GigaOhms/KLTN/images/machDK.png

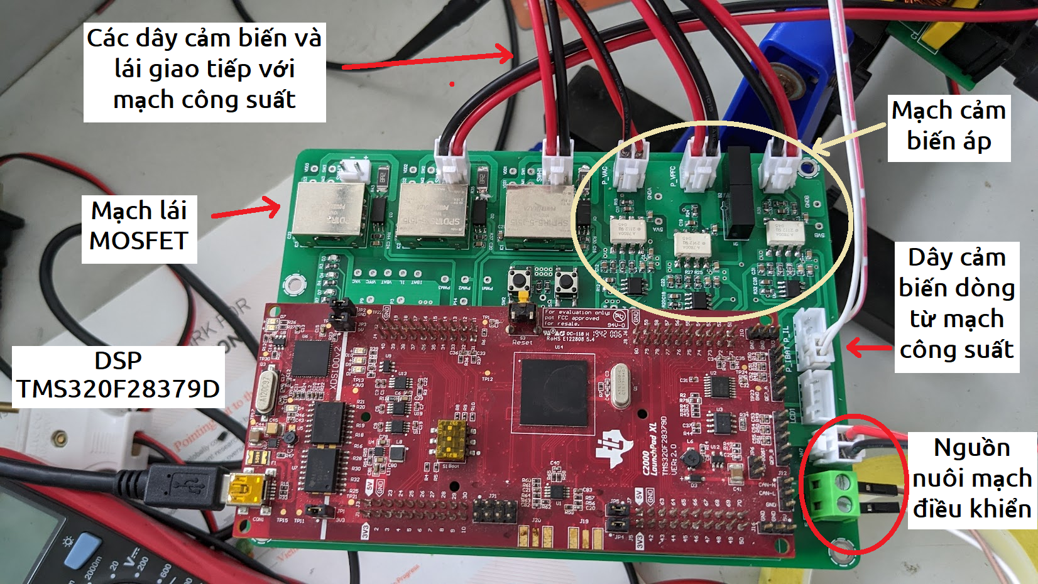
images/machDK.png
