GigaOhms/KLTN/images/ThucNghiem.png

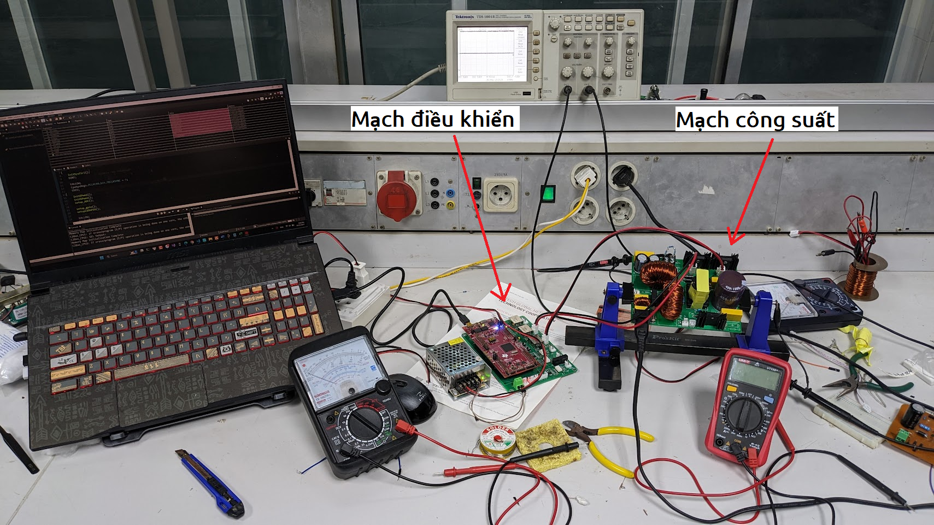
images/ThucNghiem.png
