GigaOhms/KLTN/images/2SWF_Wave.pdf

00
vL
(
m

a

g

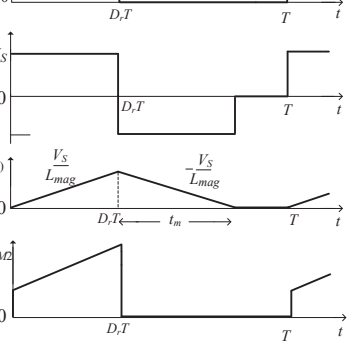
[picture p13: figure]
TDr

## )VS VS

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
VS2VS2

ttttttt

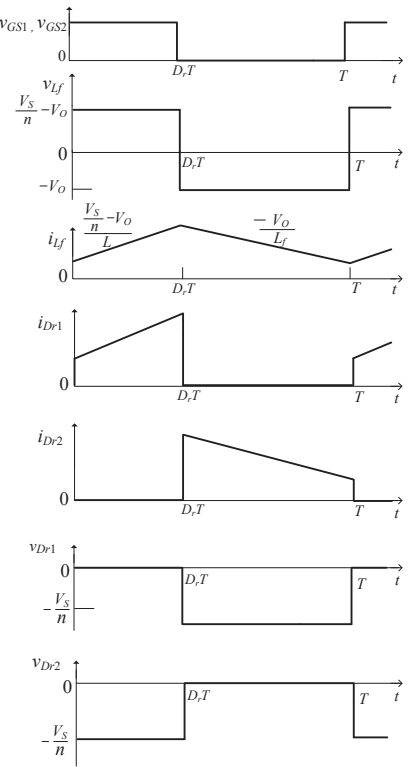
[picture p14: figure]
nVS; VOLf; VS nVS n; ttttttt; vLf iLf; TDr T

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
