GigaOhms/KLTN/Report/Calib.xlsx

 | VAC |  |  |  |  |  | VPFC |  |  |  |  |  | VBAT
 | Cal | Meas | Real (peak - DC) |  | Cal/Meas |  | Cal | Meas | Real |  | Cal/Meas |  | Cal | Meas | Real |  | Cal/Meas
1.122926244 | 1.147511493 | 1.239 | 25 | 1.179 | 139.6648045 | 157.2327044 | 2.524590164 | 2.38 | 310 | 2.32 | 238.4615385 |  | 2.538932517 | 2.4 | 30 | 2.34 | 22.3880597 | 22.72727273 | 22.70727273
1.245852489 | 1.295022986 | 1.38 | 50 | 1.32 | 156.25 | 166.6666667 | 2.573770492 | 2.4 | 320 | 2.34 | 242.4242424 |  | 2.590230268 | 2.44 | 31 | 2.38 | 22.46376812 | 22.79411765 | 22.77411765
1.491704977 | 1.590045972 | 1.64 | 100 | 1.58 | 172.4137931 | 178.5714286 | 2.62295082 | 2.43 | 330 | 2.37 | 244.4444444 |  | 2.641528018 | 2.47 | 32 | 2.41 | 22.69503546 | 23.02158273 | 23.00158273
1.614631221 | 1.737557466 | 1.77 | 125 | 1.71 | 176.056338 | 181.1594203 | 2.672131148 | 2.45 | 340 | 2.39 | 248.1751825 |  | 2.692825769 | 2.5 | 33 | 2.44 | 22.91666667 | 23.23943662 | 23.21943662
1.737557466 | 1.885068959 | 1.87 | 150 | 1.81 | 185.1851852 | 189.8734177 | 2.721311475 | 2.49 | 350 | 2.43 | 248.2269504 |  | 2.744123519 | 2.52 | 34 | 2.46 | 23.28767123 | 23.61111111 | 23.59111111
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
