GigaOhms/KLTN/images/cathode.jpg

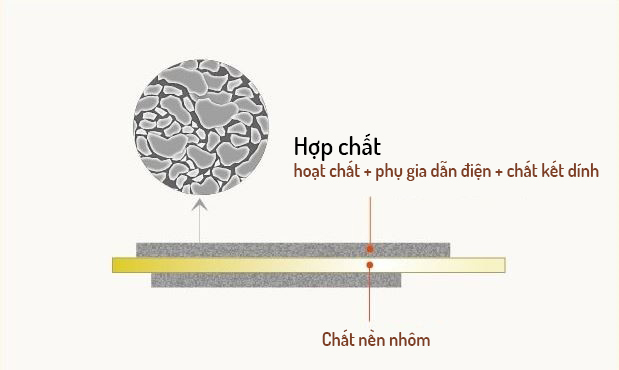
images/cathode.jpg
