GigaOhms/KLTN/images/cc-cv.jpg

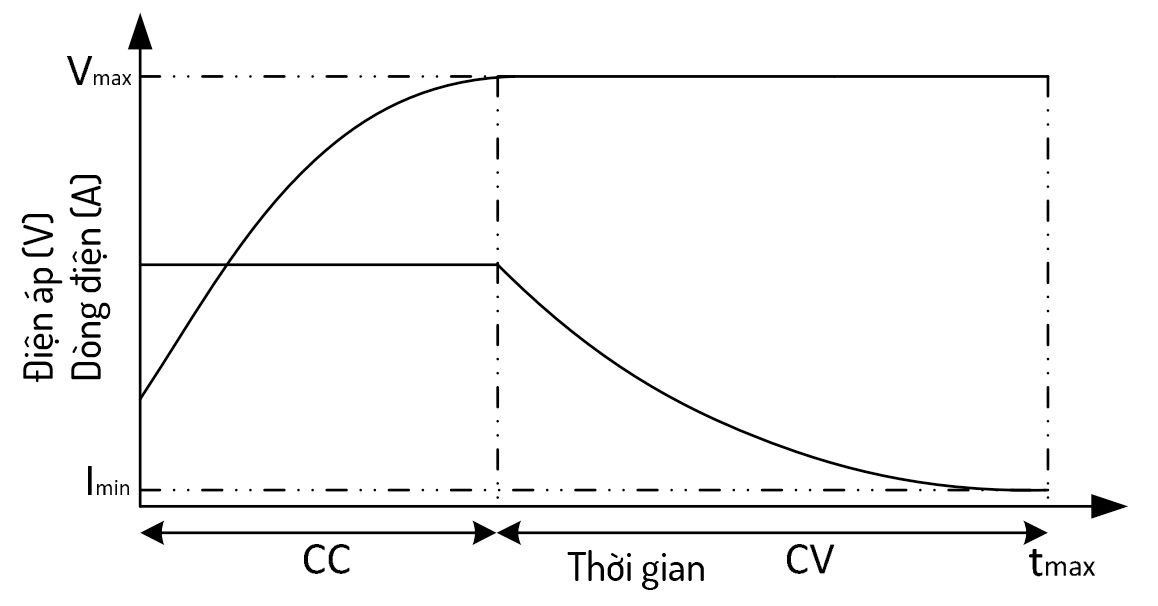
images/cc-cv.jpg
