GigaOhms/KLTN/images/CC_CV.drawio.png

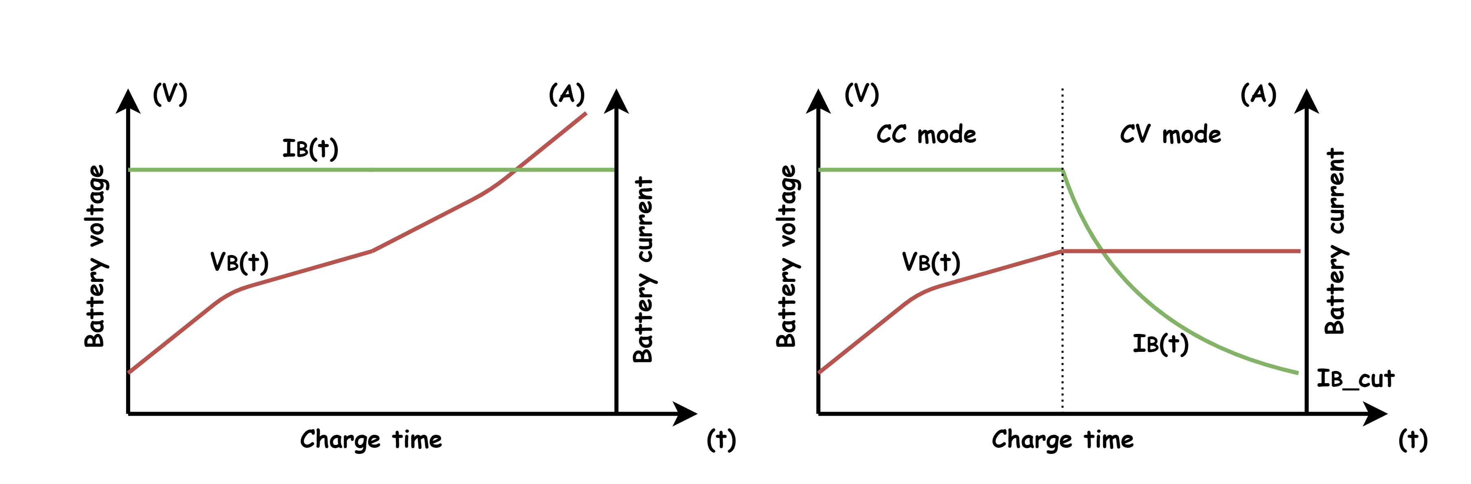
images/CC_CV.drawio.png
