GigaOhms/KLTN/images/CCM.png

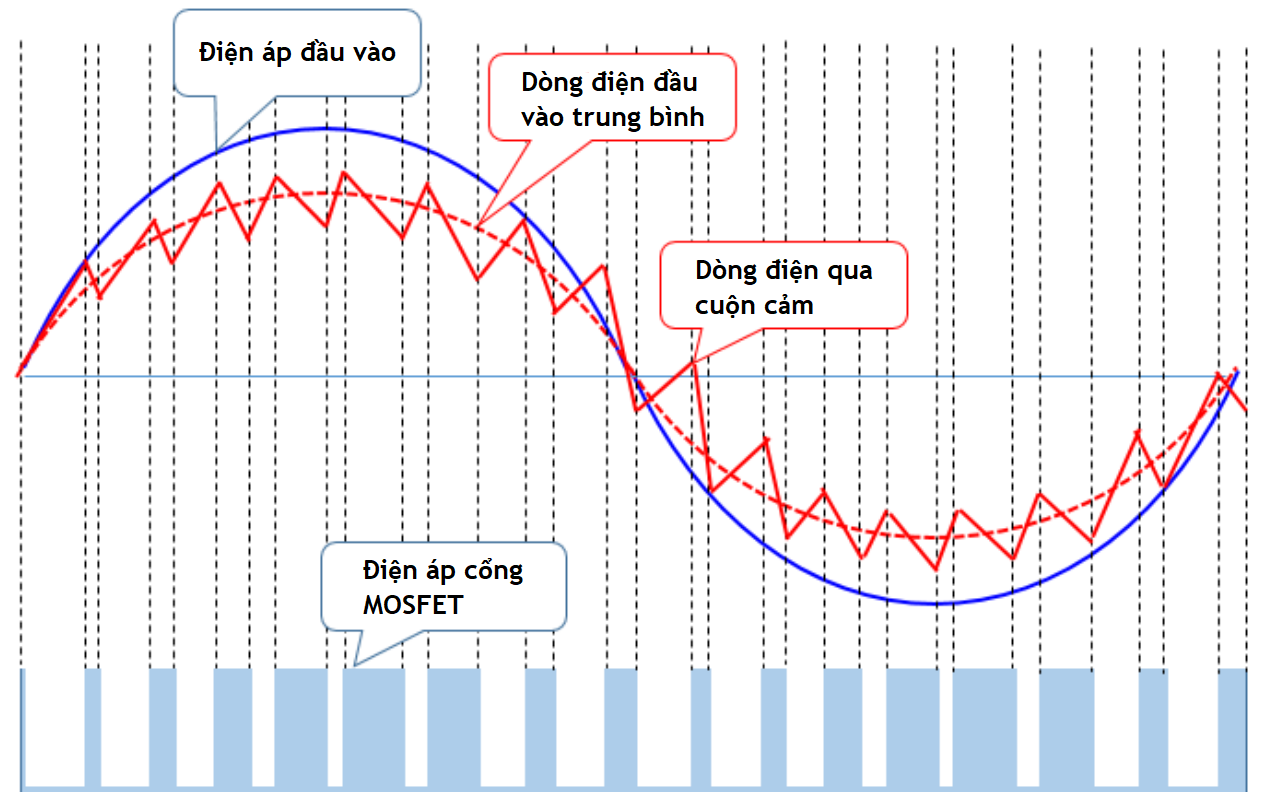
images/CCM.png
