GigaOhms/KLTN/images/charge.jpg

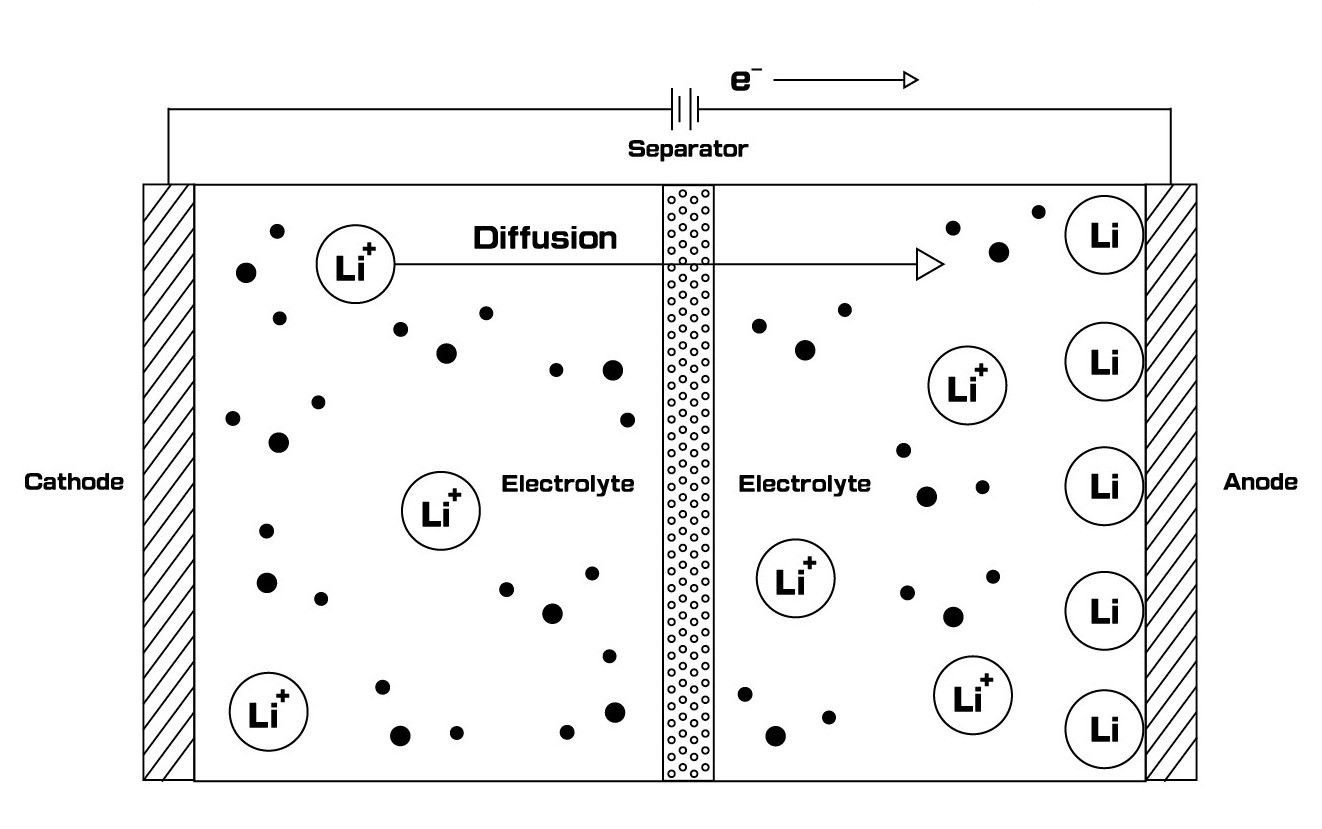
images/charge.jpg
