GigaOhms/KLTN/images/CRM.png

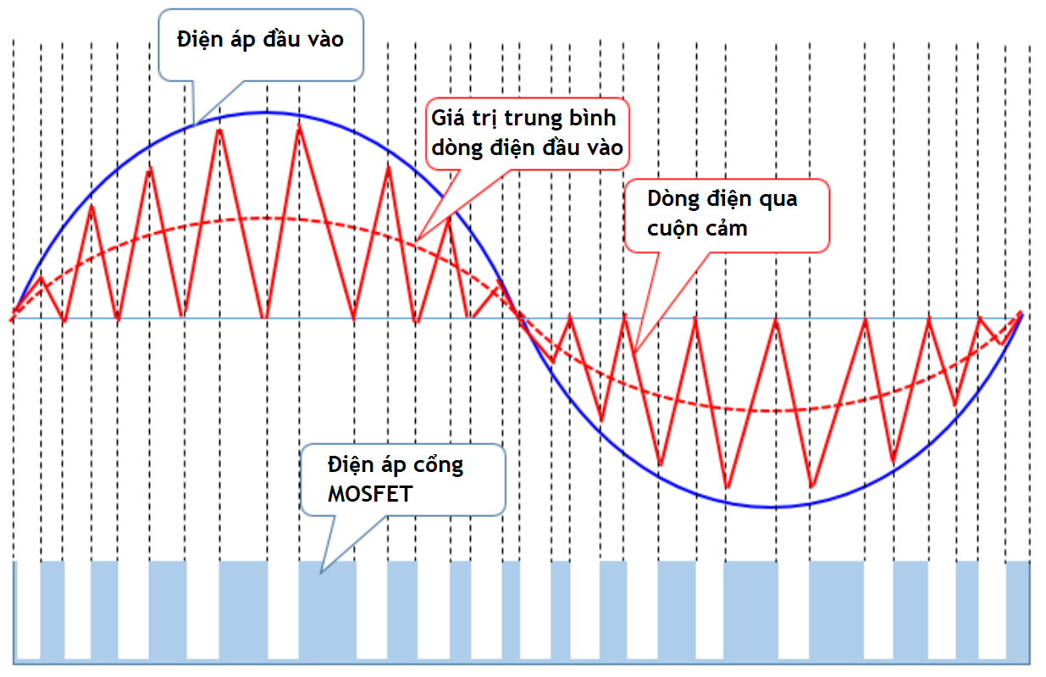
images/CRM.png
