GigaOhms/KLTN/images/CurrentIncresaEachCycle.png

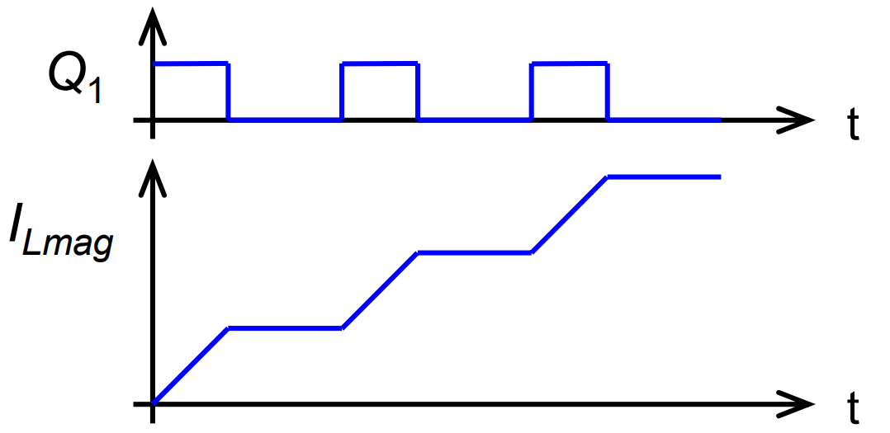
images/CurrentIncresaEachCycle.png
