GigaOhms/KLTN/images/DCM.png

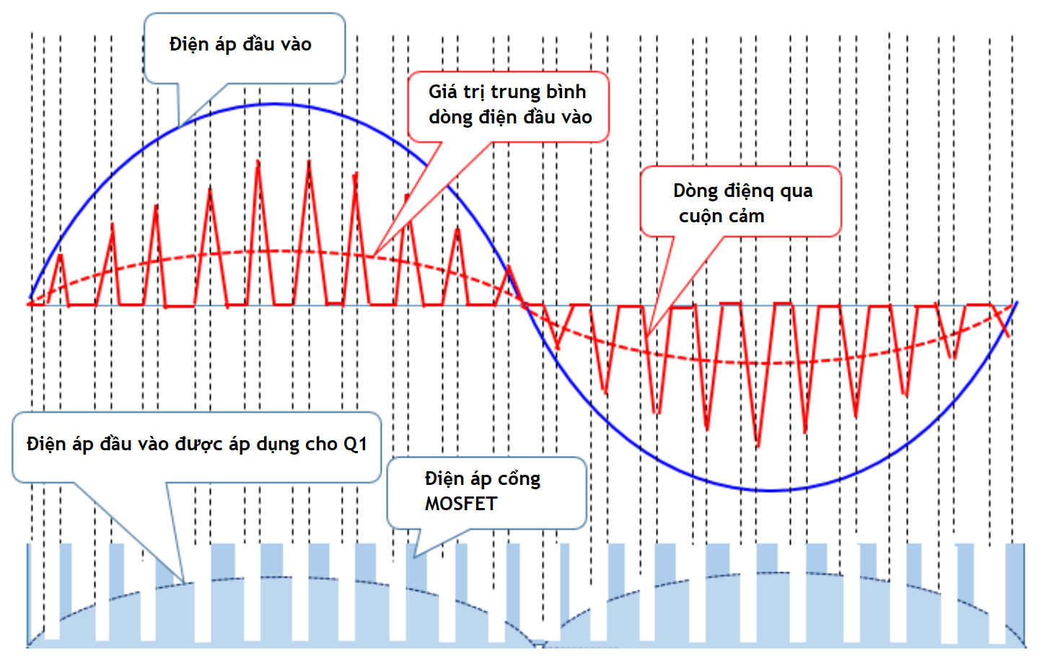
images/DCM.png
