GigaOhms/KLTN/images/discharge.jpg

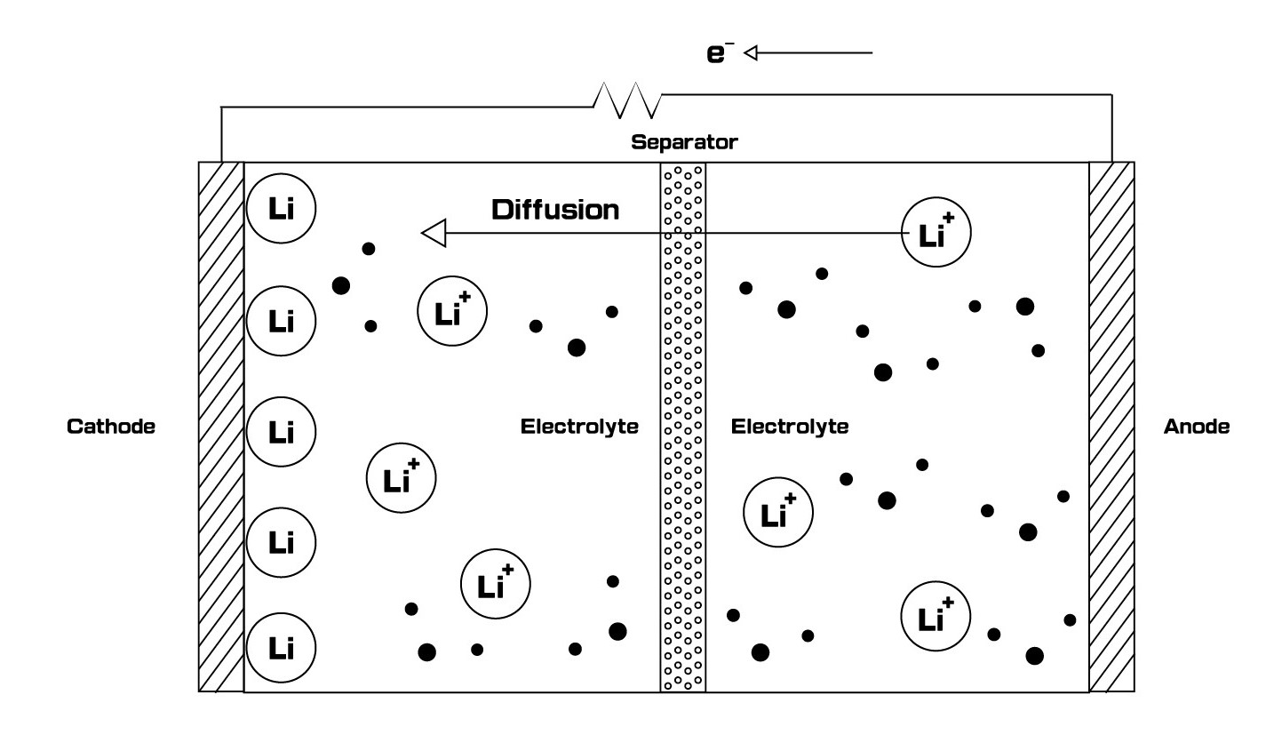
images/discharge.jpg
