GigaOhms/KLTN/images/electrist.jpg

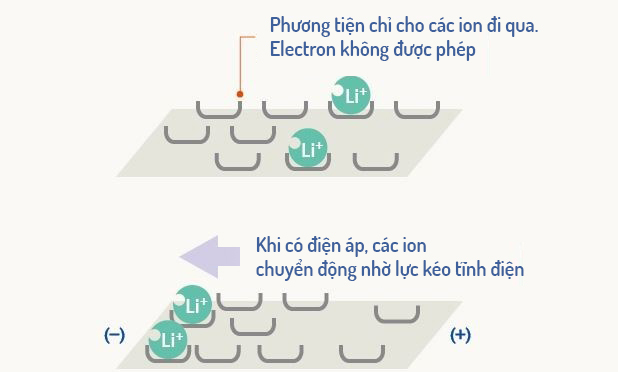
images/electrist.jpg
