GigaOhms/KLTN/images/Five-stage CC charging.jpg

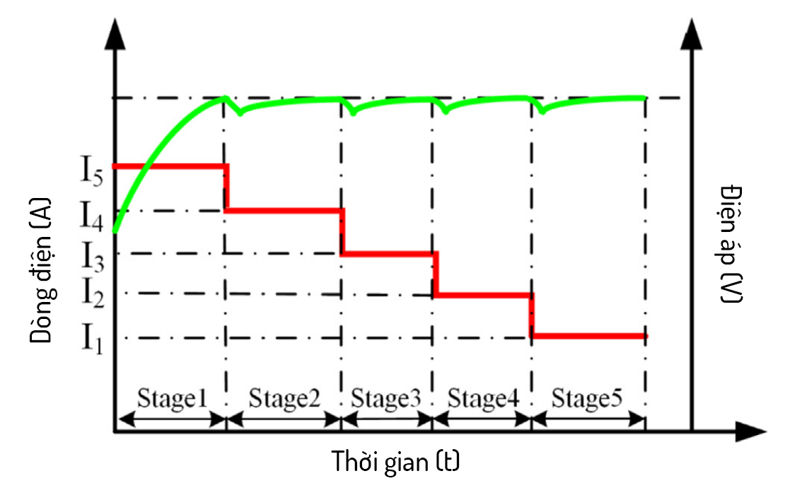
images/Five-stage CC charging.jpg
