GigaOhms/KLTN/images/fourElement.jpg

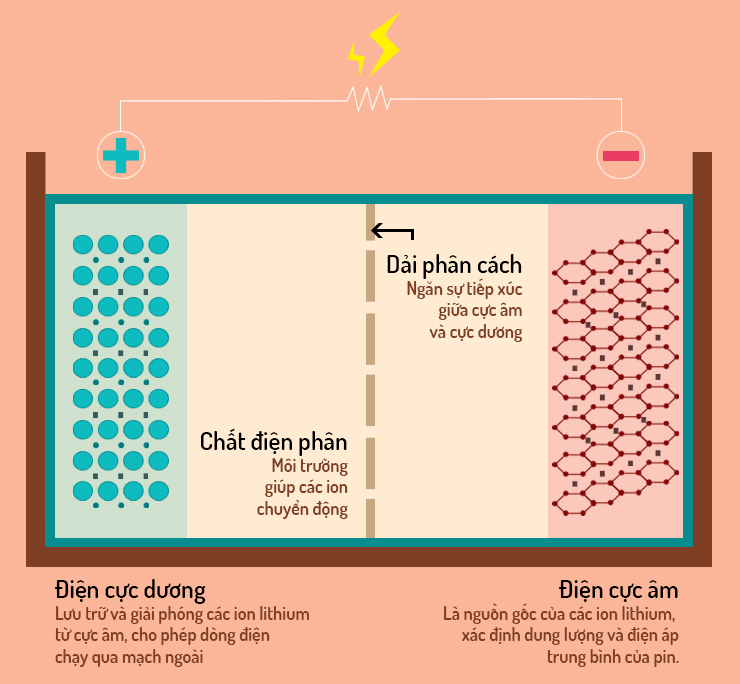
images/fourElement.jpg
