GigaOhms/KLTN/images/HD_NCKH.png

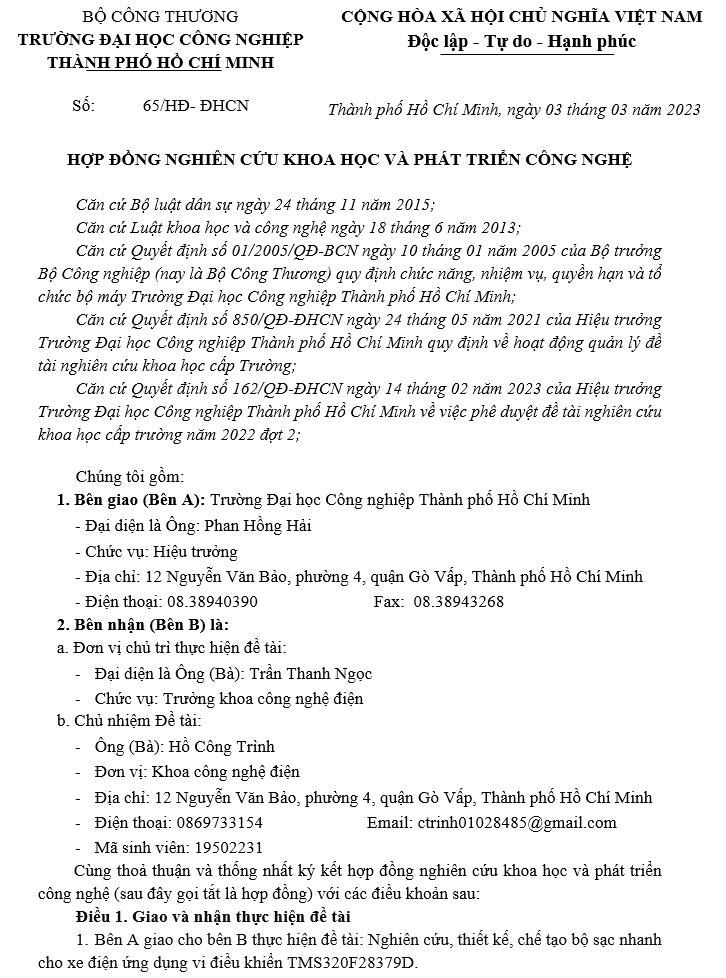
images/HD_NCKH.png
