GigaOhms/KLTN/images/iBATVBAT.png

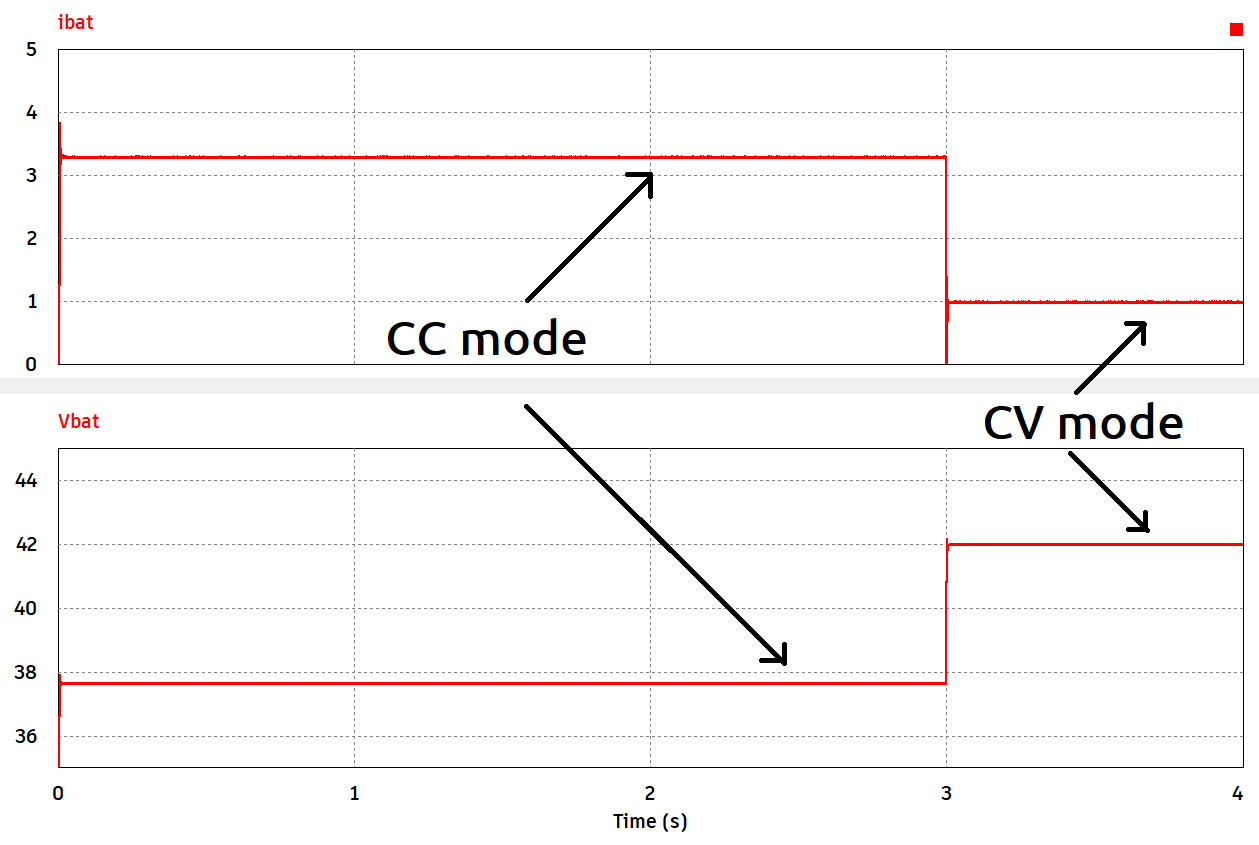
images/iBATVBAT.png
