GigaOhms/KLTN/images/iDviGBT_2sfw.png

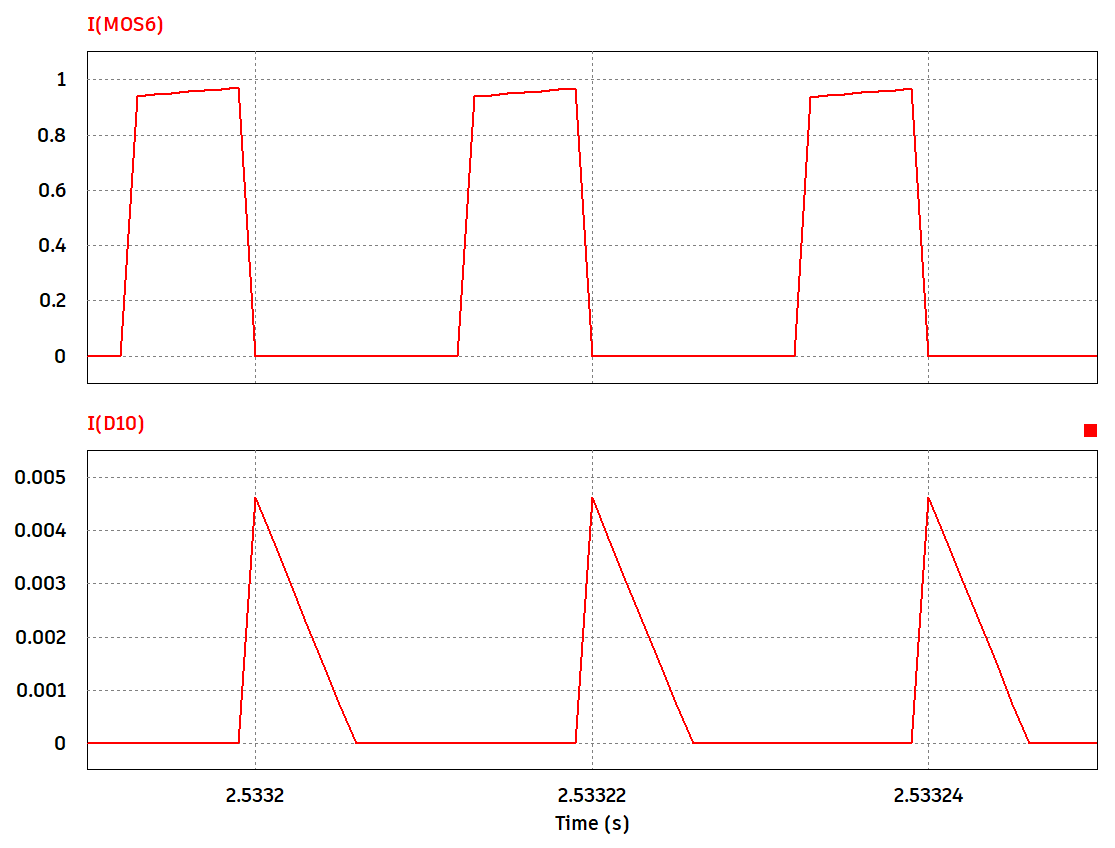
images/iDviGBT_2sfw.png
