GigaOhms/KLTN/images/iGBTviD.png

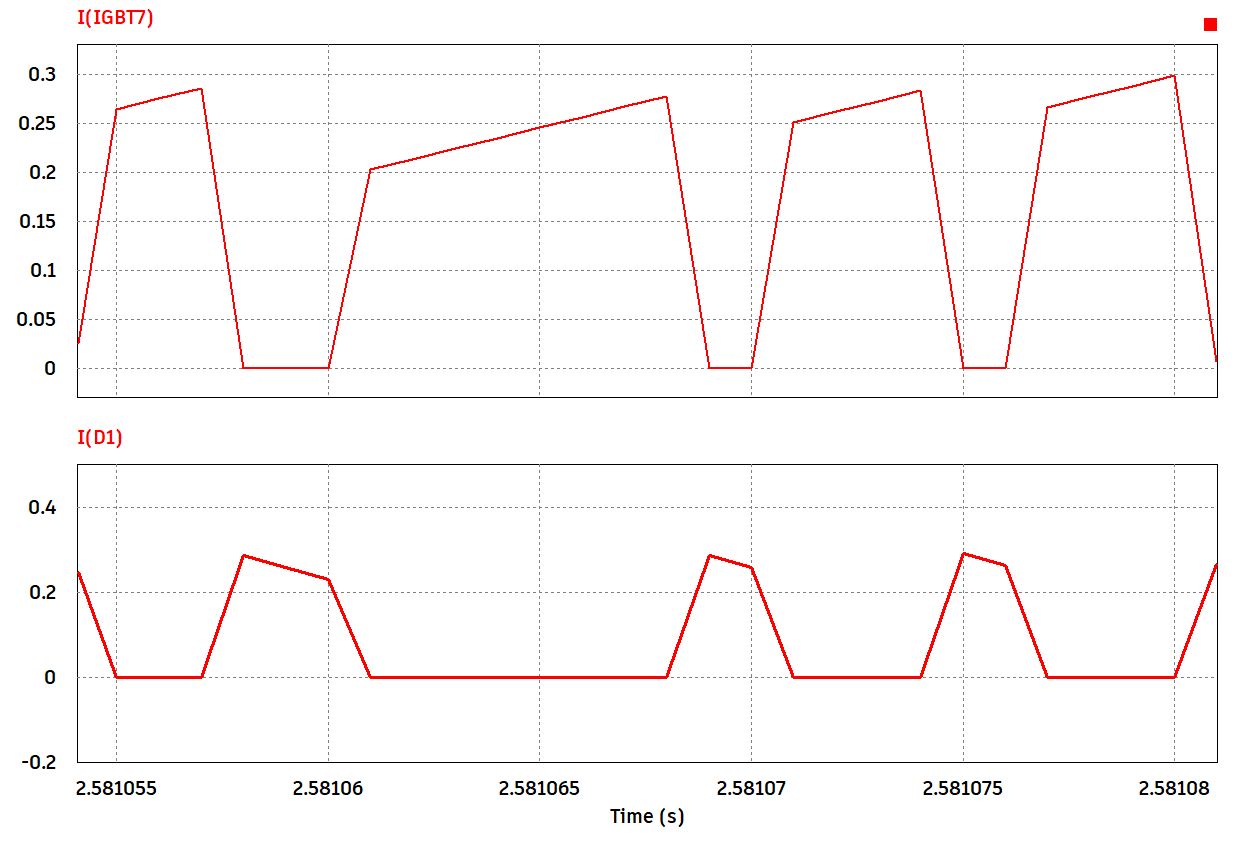
images/iGBTviD.png
