GigaOhms/KLTN/images/iLviGBT.png

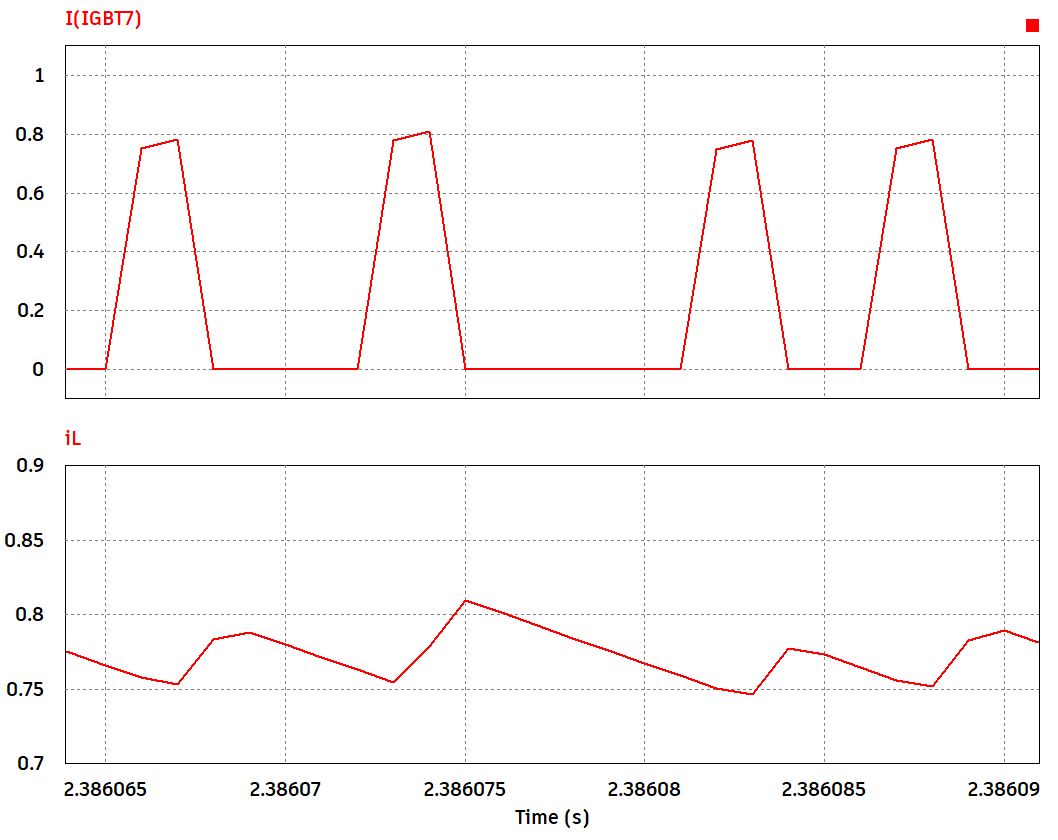
images/iLviGBT.png
