GigaOhms/KLTN/images/Improved CC-CV methods.jpg

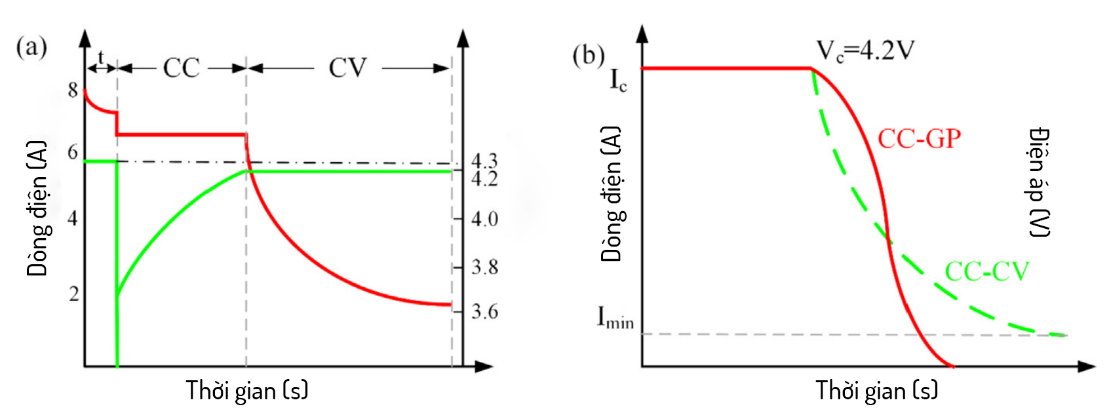
images/Improved CC-CV methods.jpg
