GigaOhms/KLTN/images/machCongSuat.png

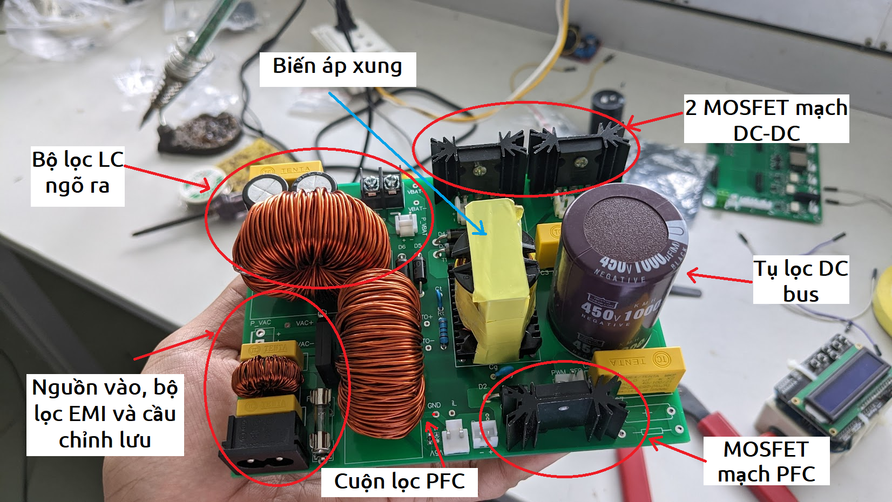
images/machCongSuat.png
