GigaOhms/KLTN/images/MoHinh.png

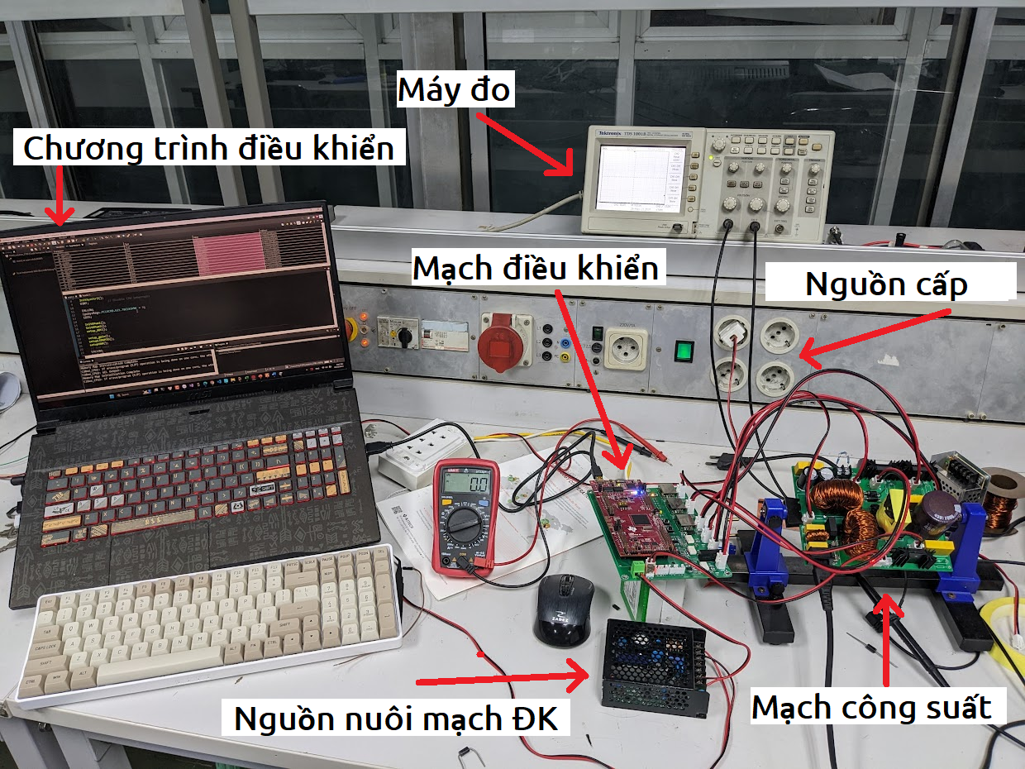
images/MoHinh.png
