GigaOhms/KLTN/images/NoneLinearLoad.png

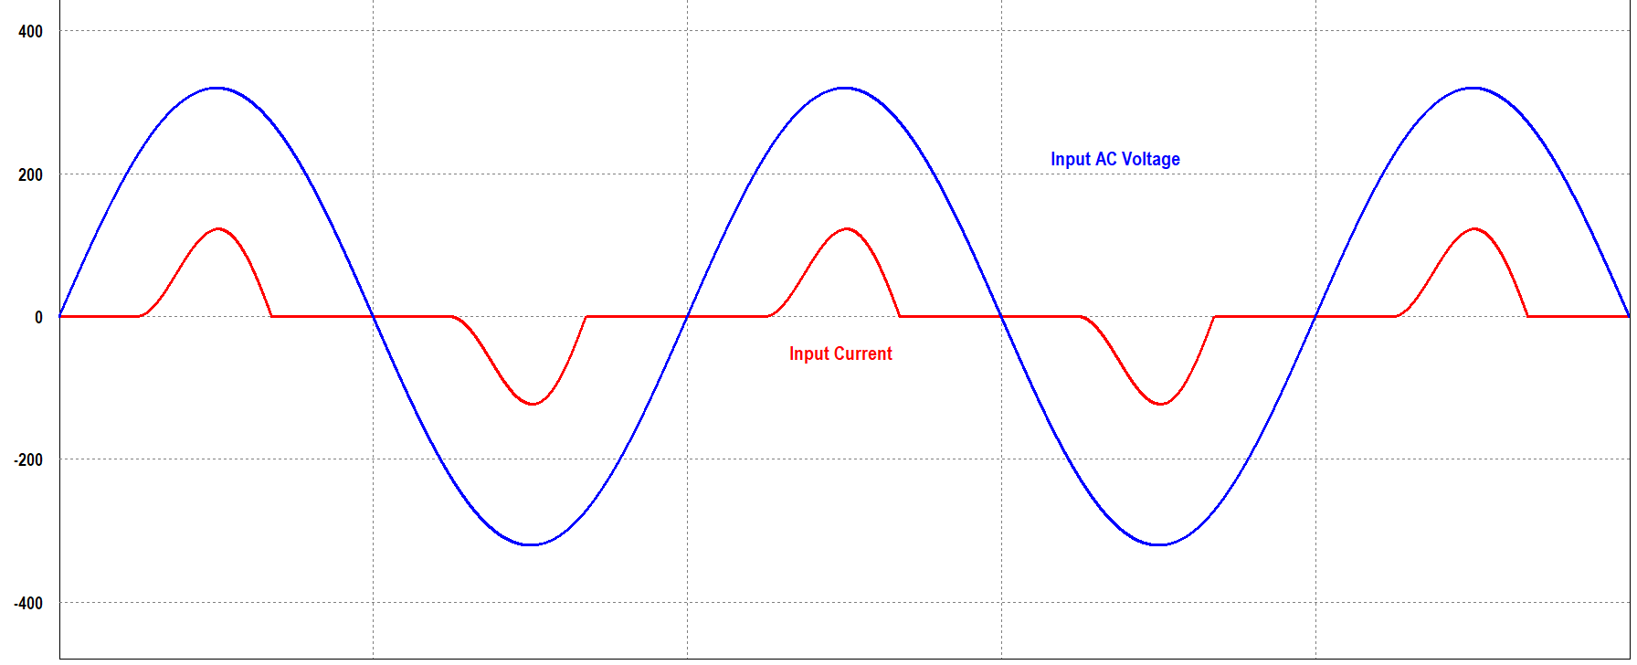
images/NoneLinearLoad.png
