GigaOhms/KLTN/images/NonLinearLoad.png

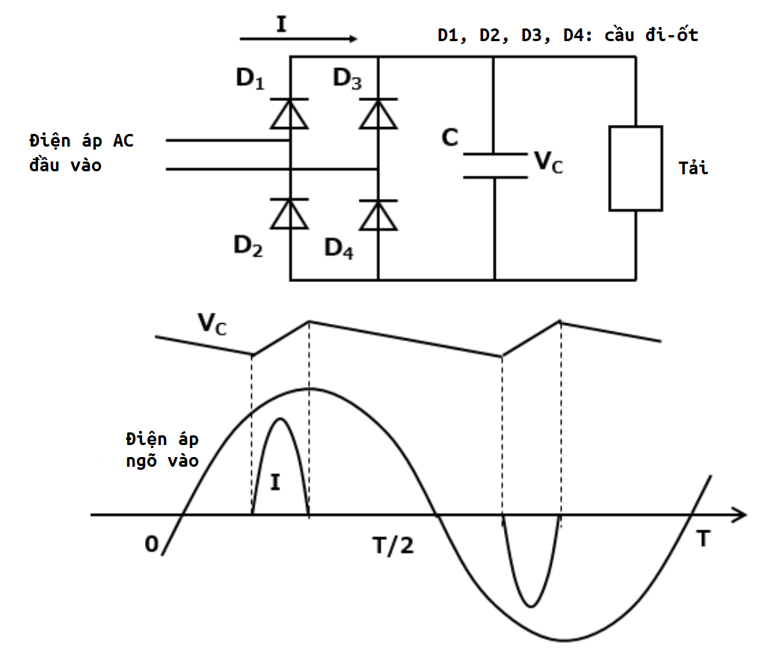
images/NonLinearLoad.png
