GigaOhms/KLTN/images/pfc1-01.png

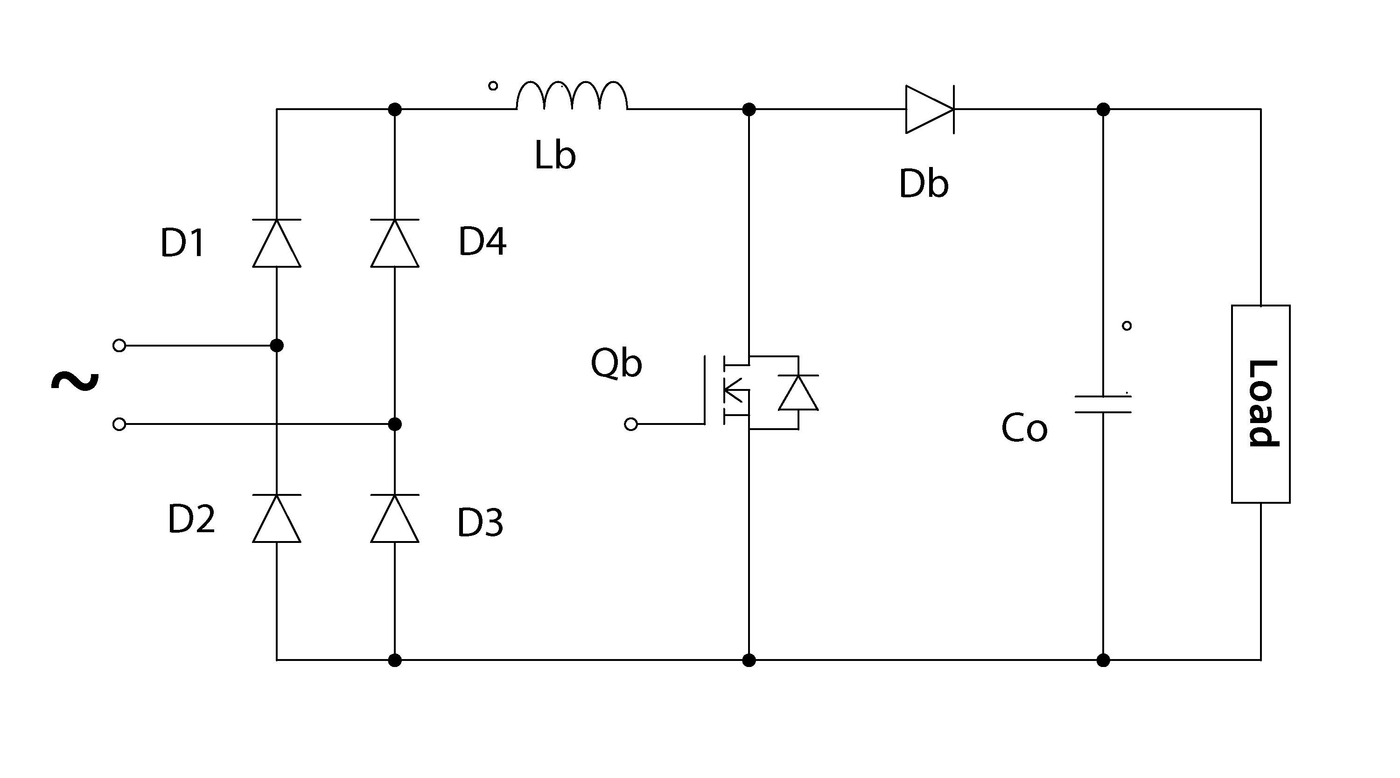
images/pfc1-01.png
