GigaOhms/KLTN/images/pfc2-01.png

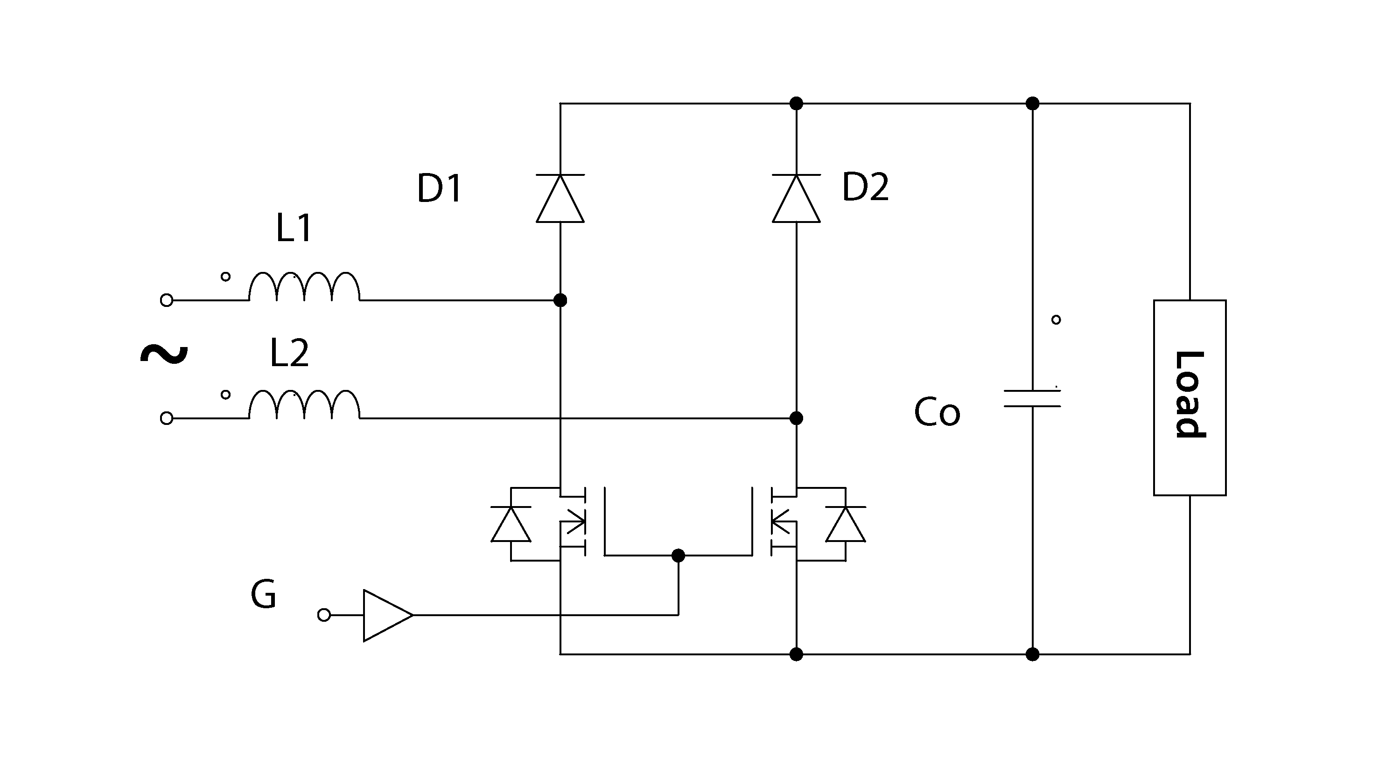
images/pfc2-01.png
