GigaOhms/KLTN/images/pfc3-01.png

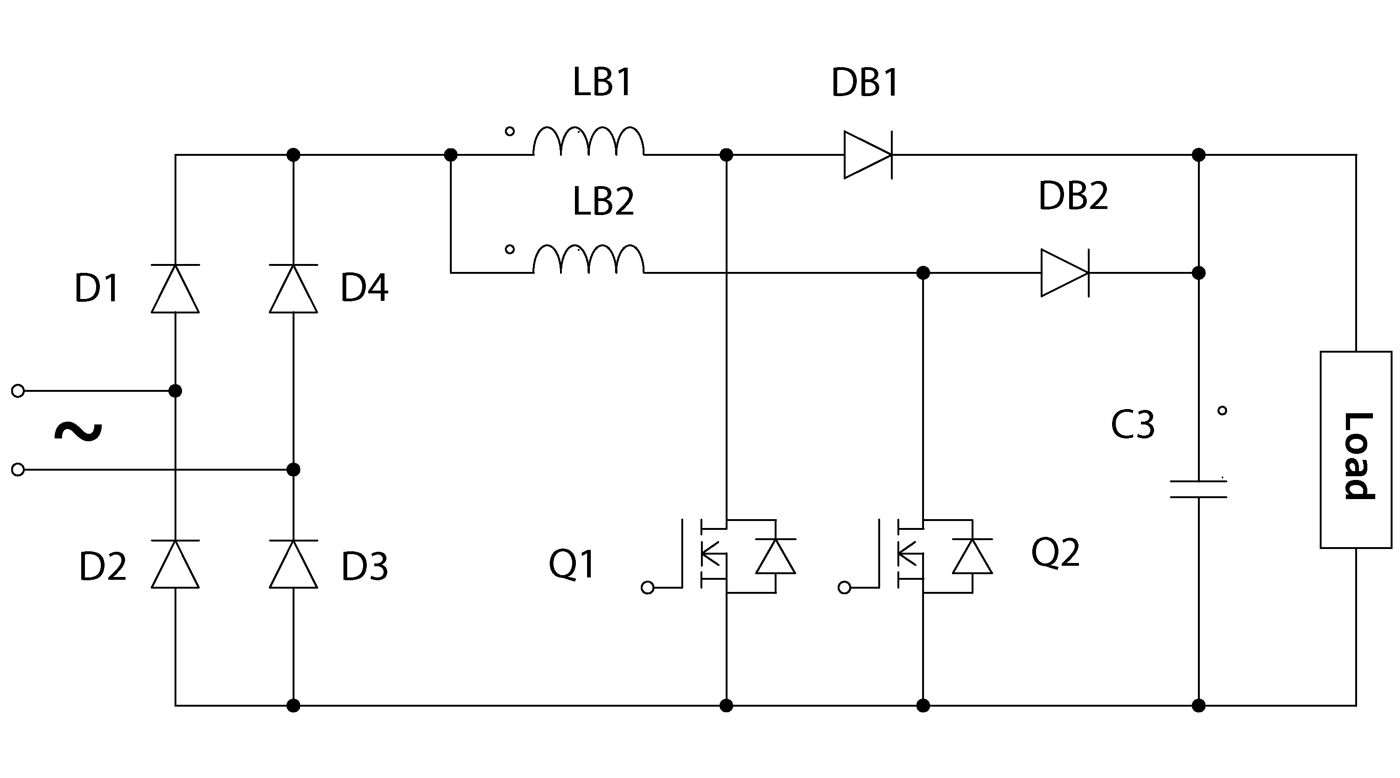
images/pfc3-01.png
