GigaOhms/KLTN/images/pfc4 - topo-01-01.png

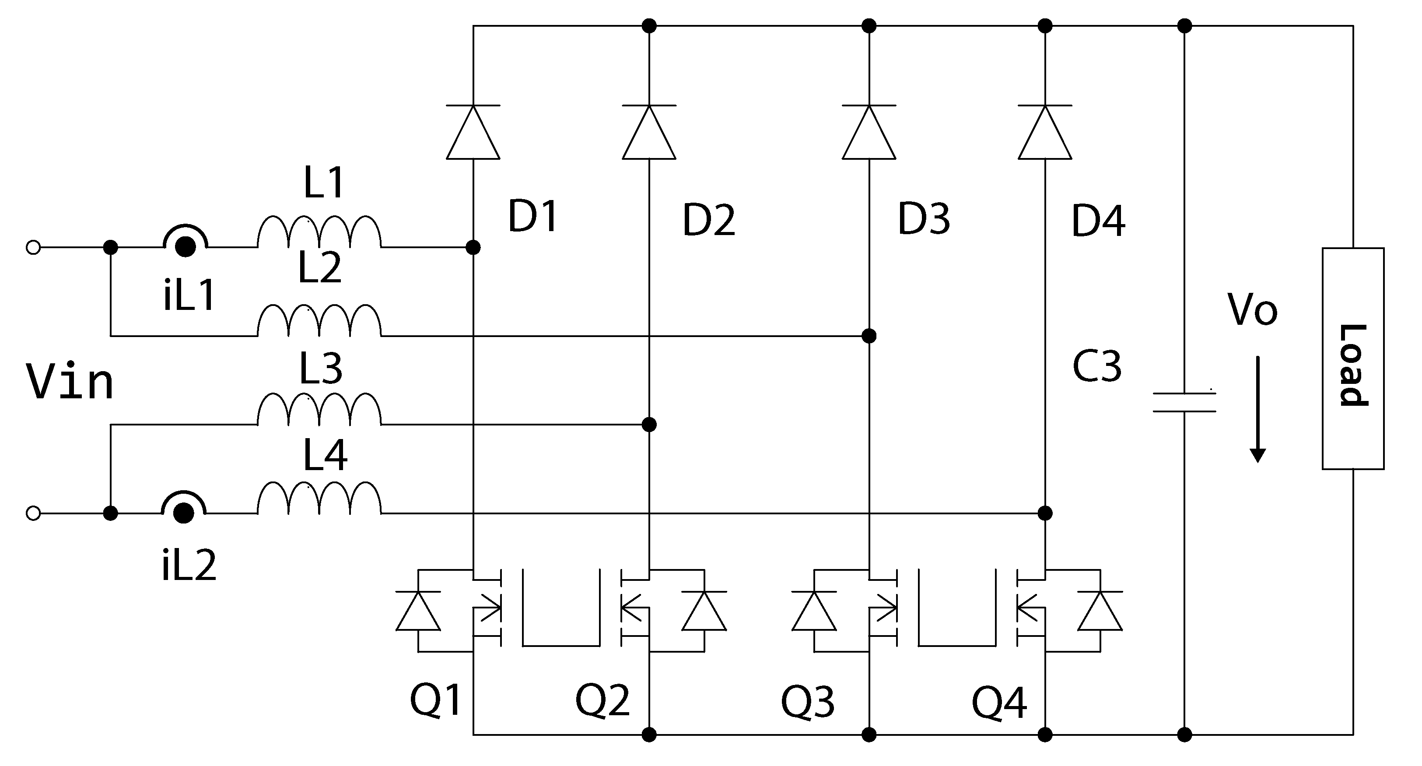
images/pfc4 - topo-01-01.png
