GigaOhms/KLTN/images/PFC-01.png

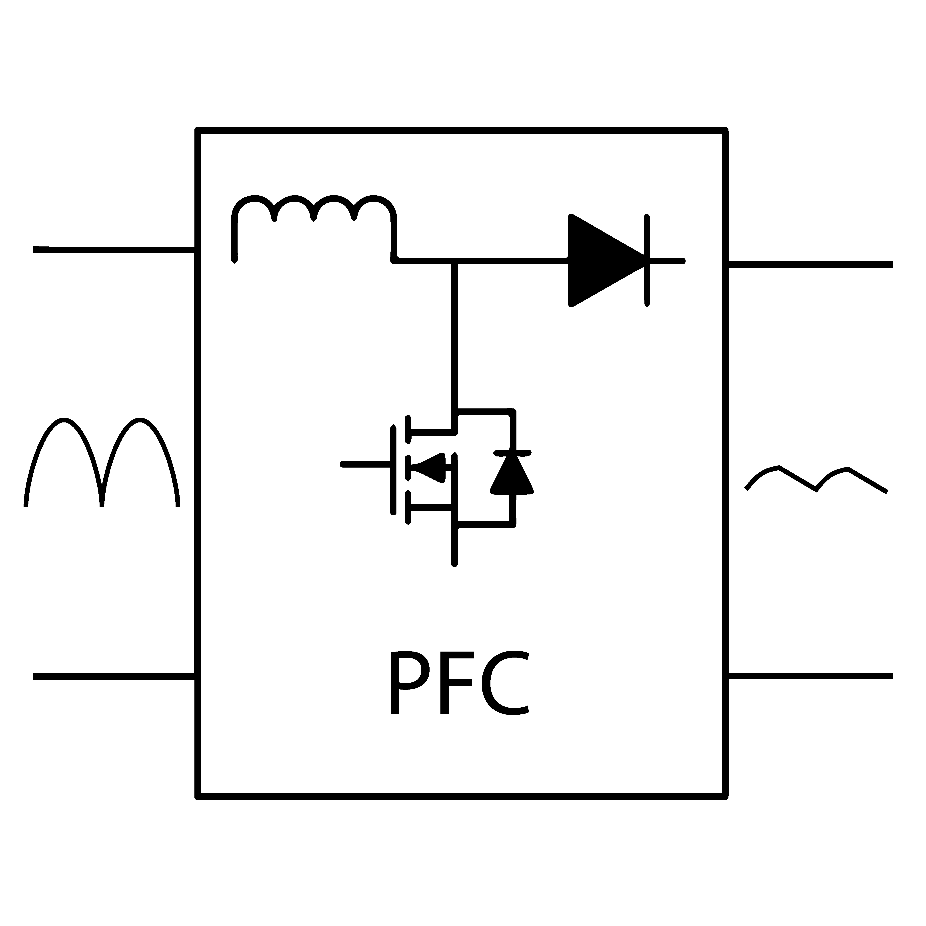
images/PFC-01.png
