GigaOhms/KLTN/images/PFvTHD.png

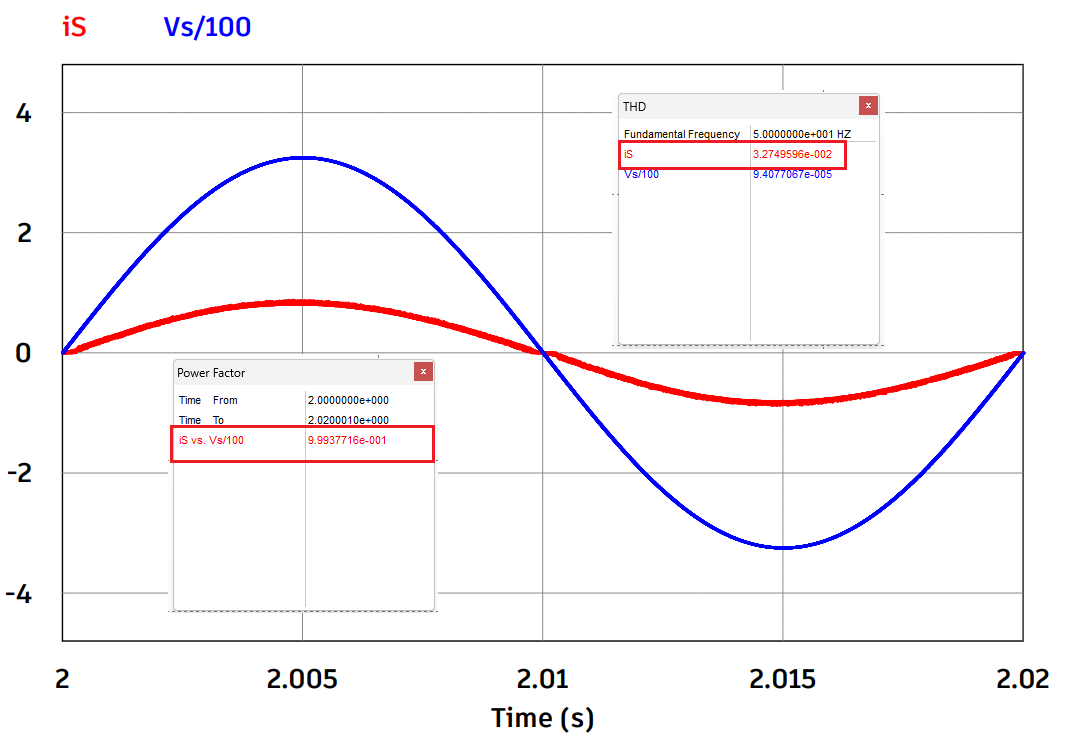
images/PFvTHD.png
