GigaOhms/KLTN/images/separator.png

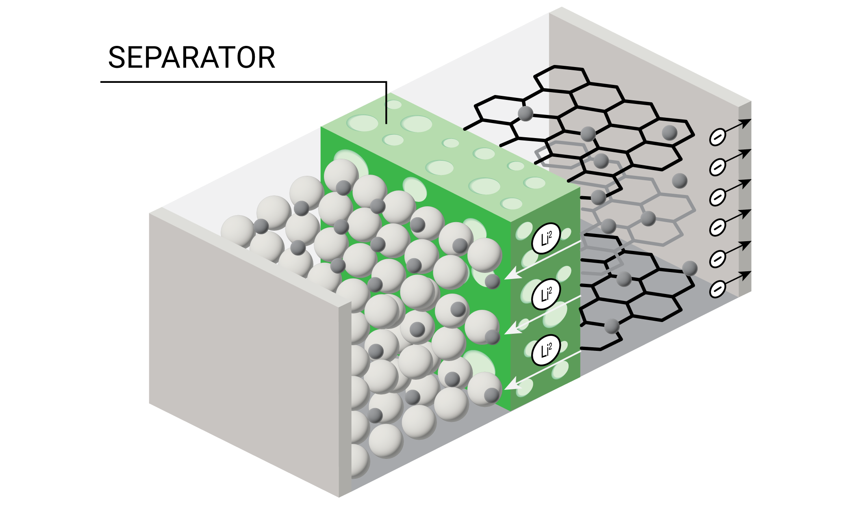
images/separator.png
