GigaOhms/KLTN/images/TM_Tram.png

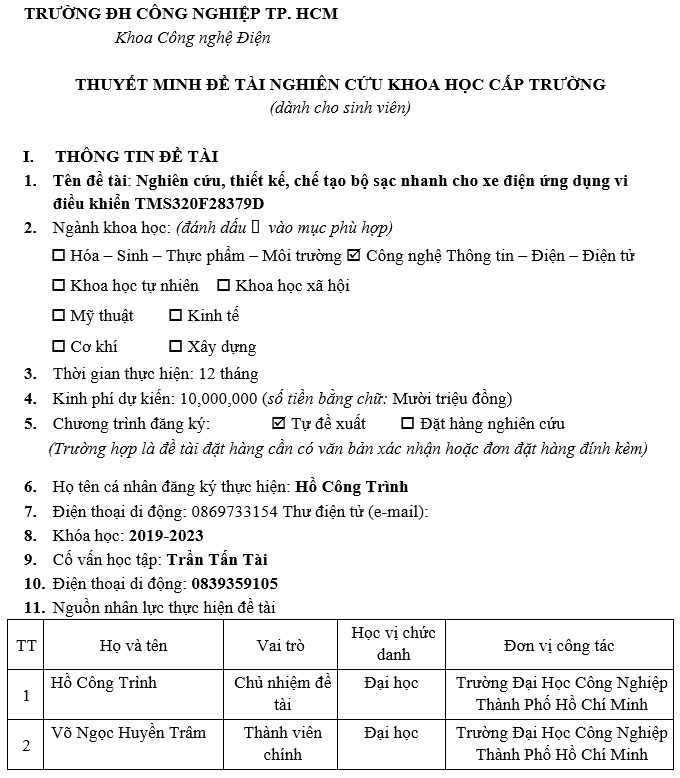
images/TM_Tram.png
