GigaOhms/KLTN/images/universalBatteryCharger.drawio.png

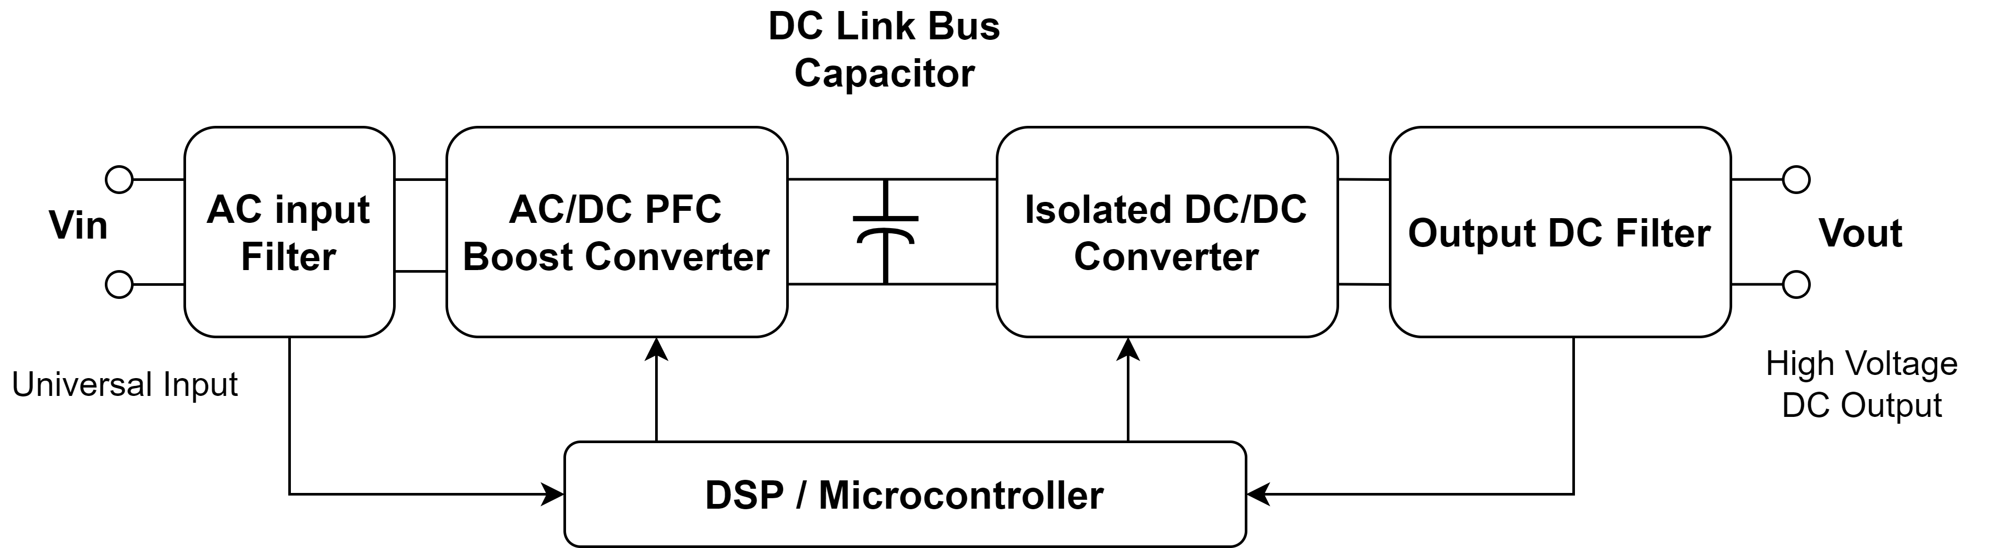
images/universalBatteryCharger.drawio.png
