GigaOhms/KLTN/images/Vbus.png

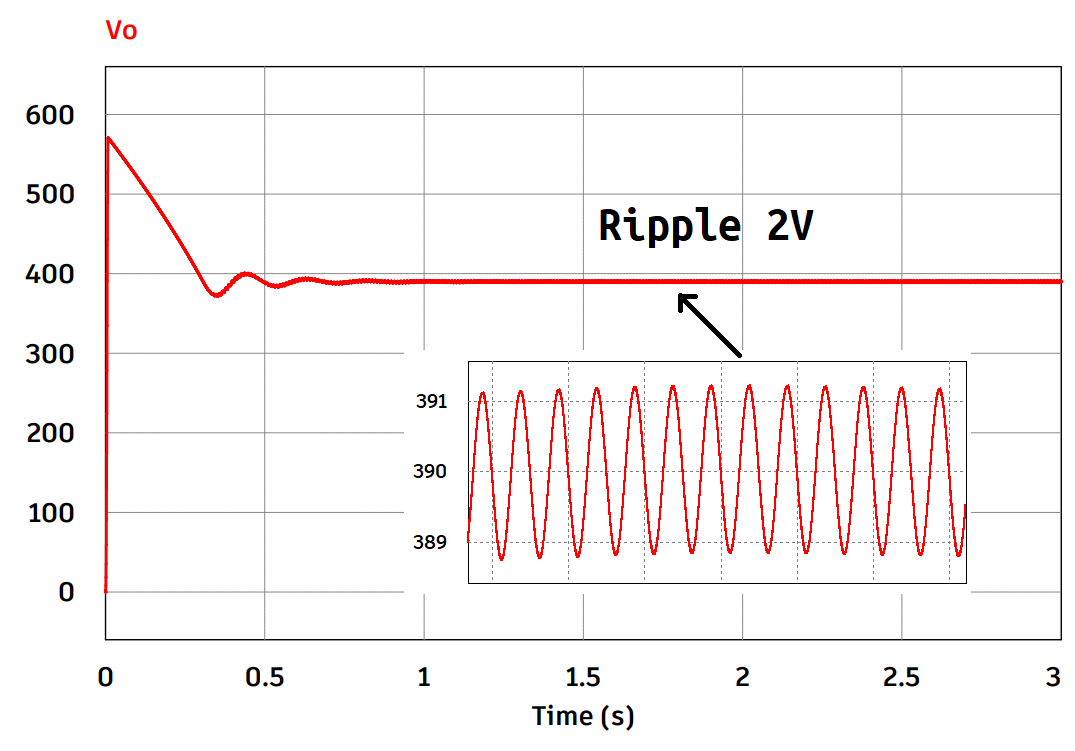
images/Vbus.png
