GigaOhms/KLTN/images/YSC1.png

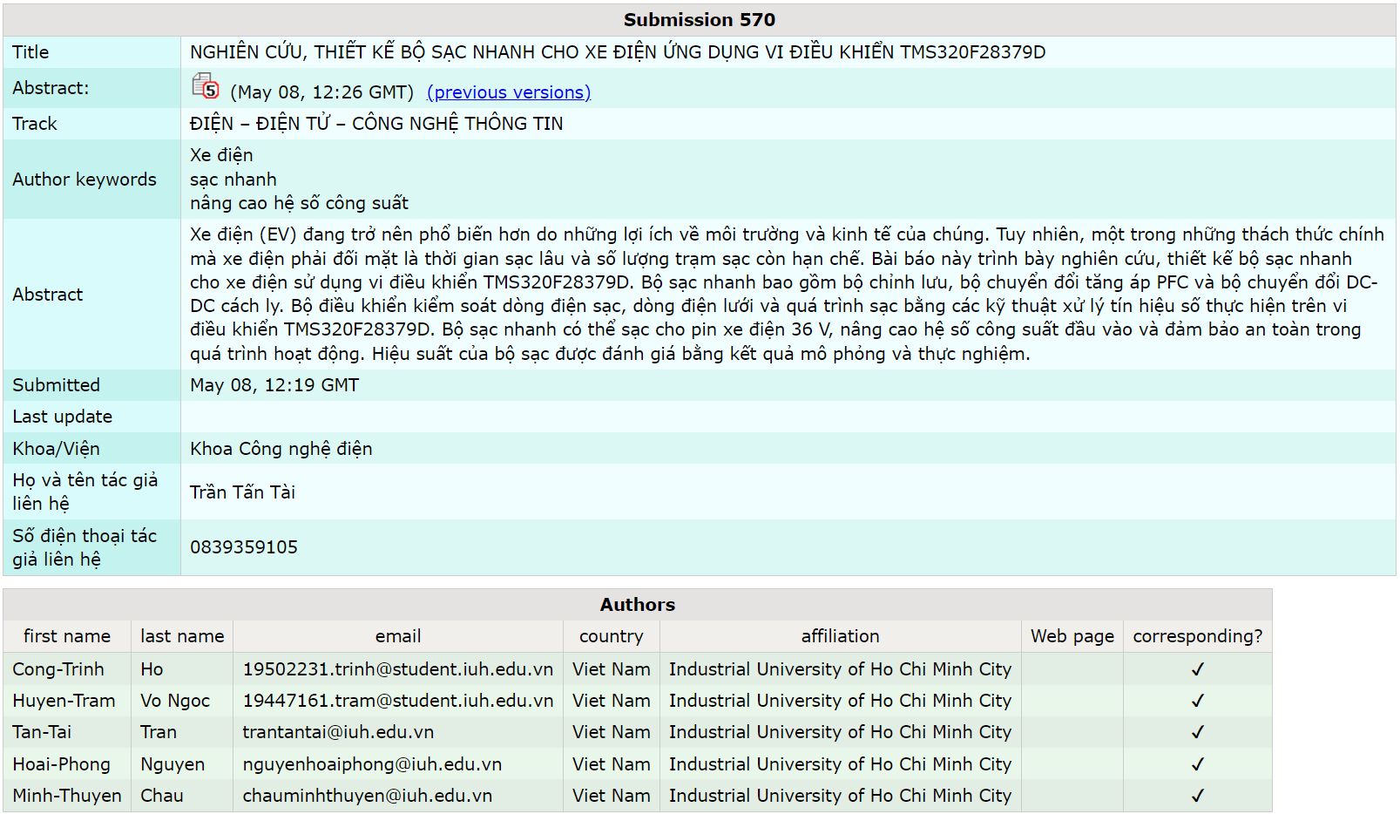
images/YSC1.png
