GigaOhms/KLTN/images/YSC2.png

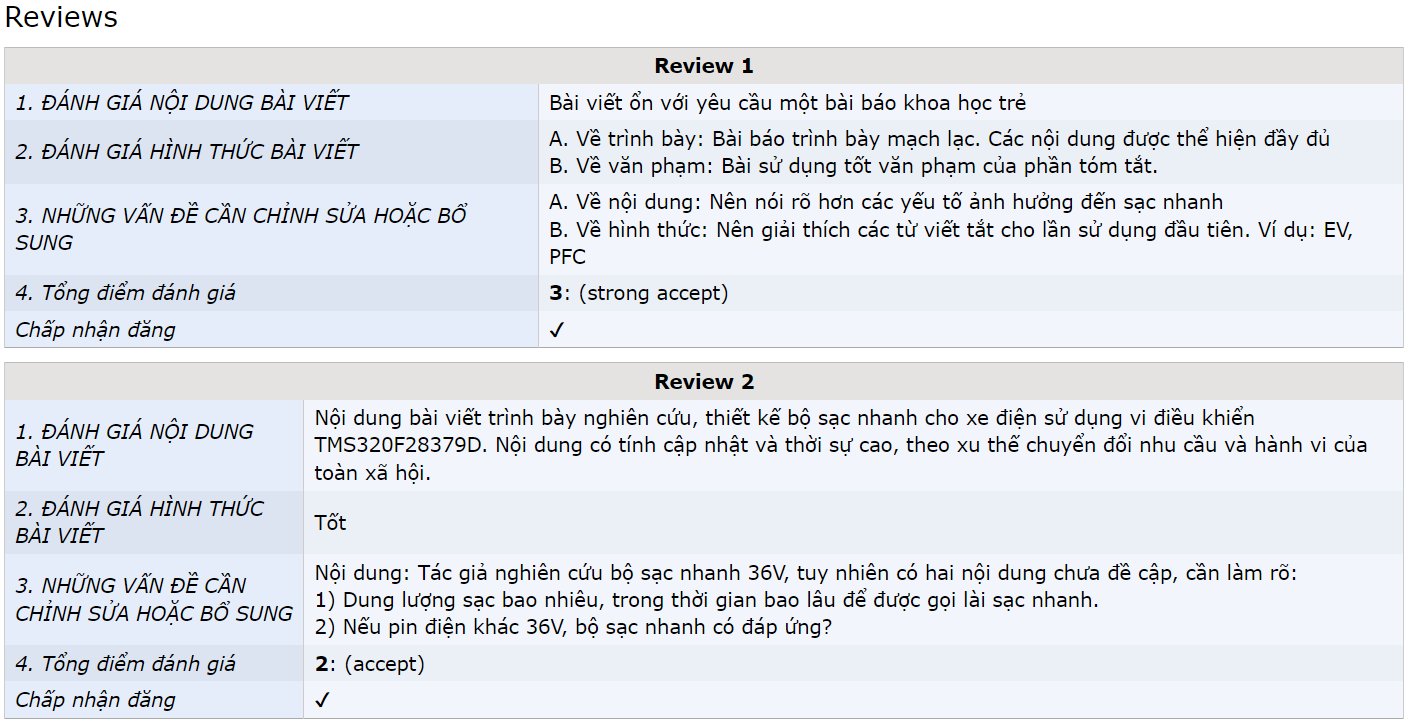
images/YSC2.png
