GigaOhms/KLTN/(list of files, cad)

Other CAD files:
Code/RANDOM/CPU1_RAM/main.obj
Code/RANDOM/CPU1_FLASH/main.obj
Code/RANDOM/CPU1_FLASH/F2837xD_CodeStartBranch.obj
Code/RANDOM/CPU1_RAM/F2837xD_EPwm.obj
Code/RANDOM/CPU1_FLASH/F2837xD_PieVect.obj
Code/RANDOM/CPU1_RAM/F2837xD_PieVect.obj
Code/RANDOM/CPU1_FLASH/F2837xD_Gpio.obj
Code/RANDOM/CPU1_RAM/F2837xD_Adc.obj
Code/RANDOM/CPU1_FLASH/F2837xD_EPwm.obj
Code/RANDOM/CPU1_RAM/F2837xD_usDelay.obj
Code/RANDOM/CPU1_FLASH/F2837xD_CpuTimers.obj
Code/RANDOM/CPU1_FLASH/F2837xD_SysCtrl.obj
Code/RANDOM/CPU1_RAM/F2837xD_DefaultISR.obj
Code/RANDOM/CPU1_FLASH/F2837xD_usDelay.obj
Code/RANDOM/CPU1_RAM/F2837xD_GlobalVariableDefs.obj
Code/RANDOM/CPU1_FLASH/F2837xD_PieCtrl.obj
Code/RANDOM/CPU1_RAM/F2837xD_CpuTimers.obj
Code/RANDOM/CPU1_FLASH/F2837xD_Adc.obj
Code/RANDOM/CPU1_RAM/epwm_updown_aq_cpu01.obj
Code/RANDOM/CPU1_FLASH/F2837xD_DefaultISR.obj
Code/RANDOM/CPU1_RAM/F2837xD_PieCtrl.obj
Code/RANDOM/CPU1_RAM/F2837xD_Gpio.obj
Code/RANDOM/CPU1_FLASH/F2837xD_Ipc.obj
Code/RANDOM/CPU1_RAM/F2837xD_Ipc.obj
Code/RANDOM/CPU1_FLASH/F2837xD_GlobalVariableDefs.obj
Code/RANDOM/CPU1_RAM/F2837xD_SysCtrl.obj
Code/RANDOM/CPU1_RAM/F2837xD_CodeStartBranch.obj
