GigaOhms/KLTN/images/ThreeStep2SWF.png

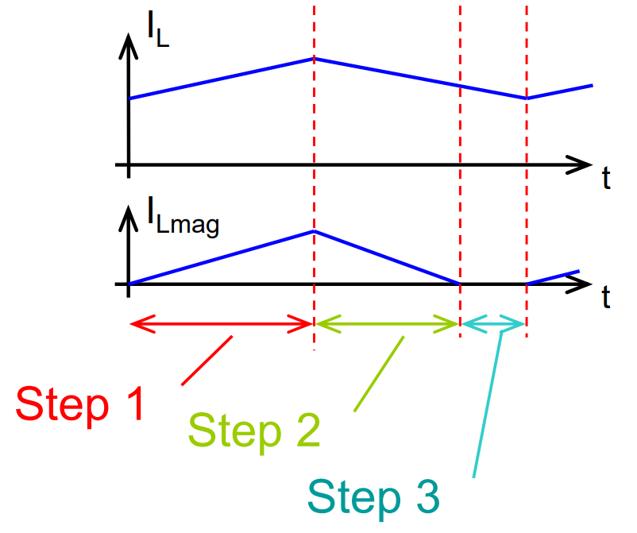
images/ThreeStep2SWF.png
