GigaOhms/KLTN/PCB/ControlBoard/ControlBoardSchematic.pdf

# GNDLED¹

# GNDLED³

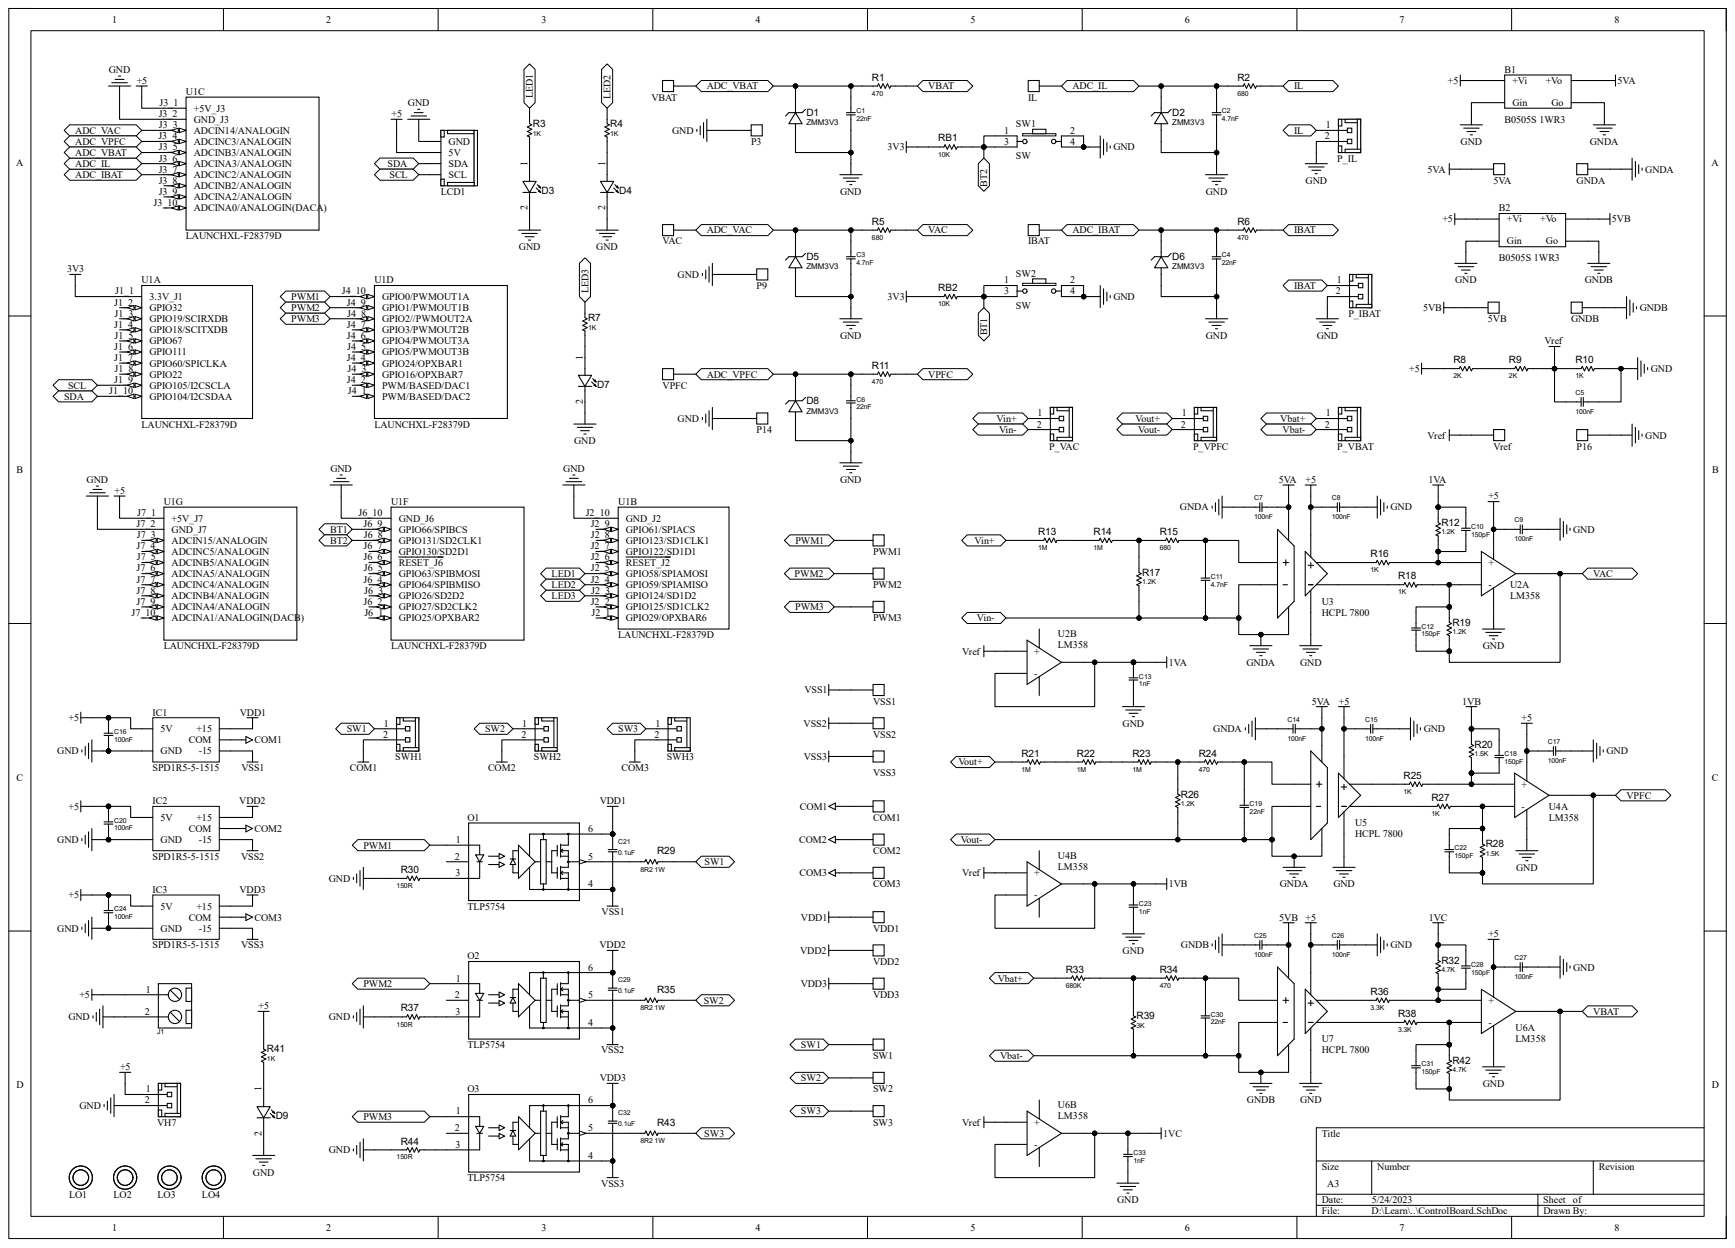
[picture p50: page 1]
