GigaOhms/KLTN/PCB/PowerBoard/PowerBoardSchematic.pdf

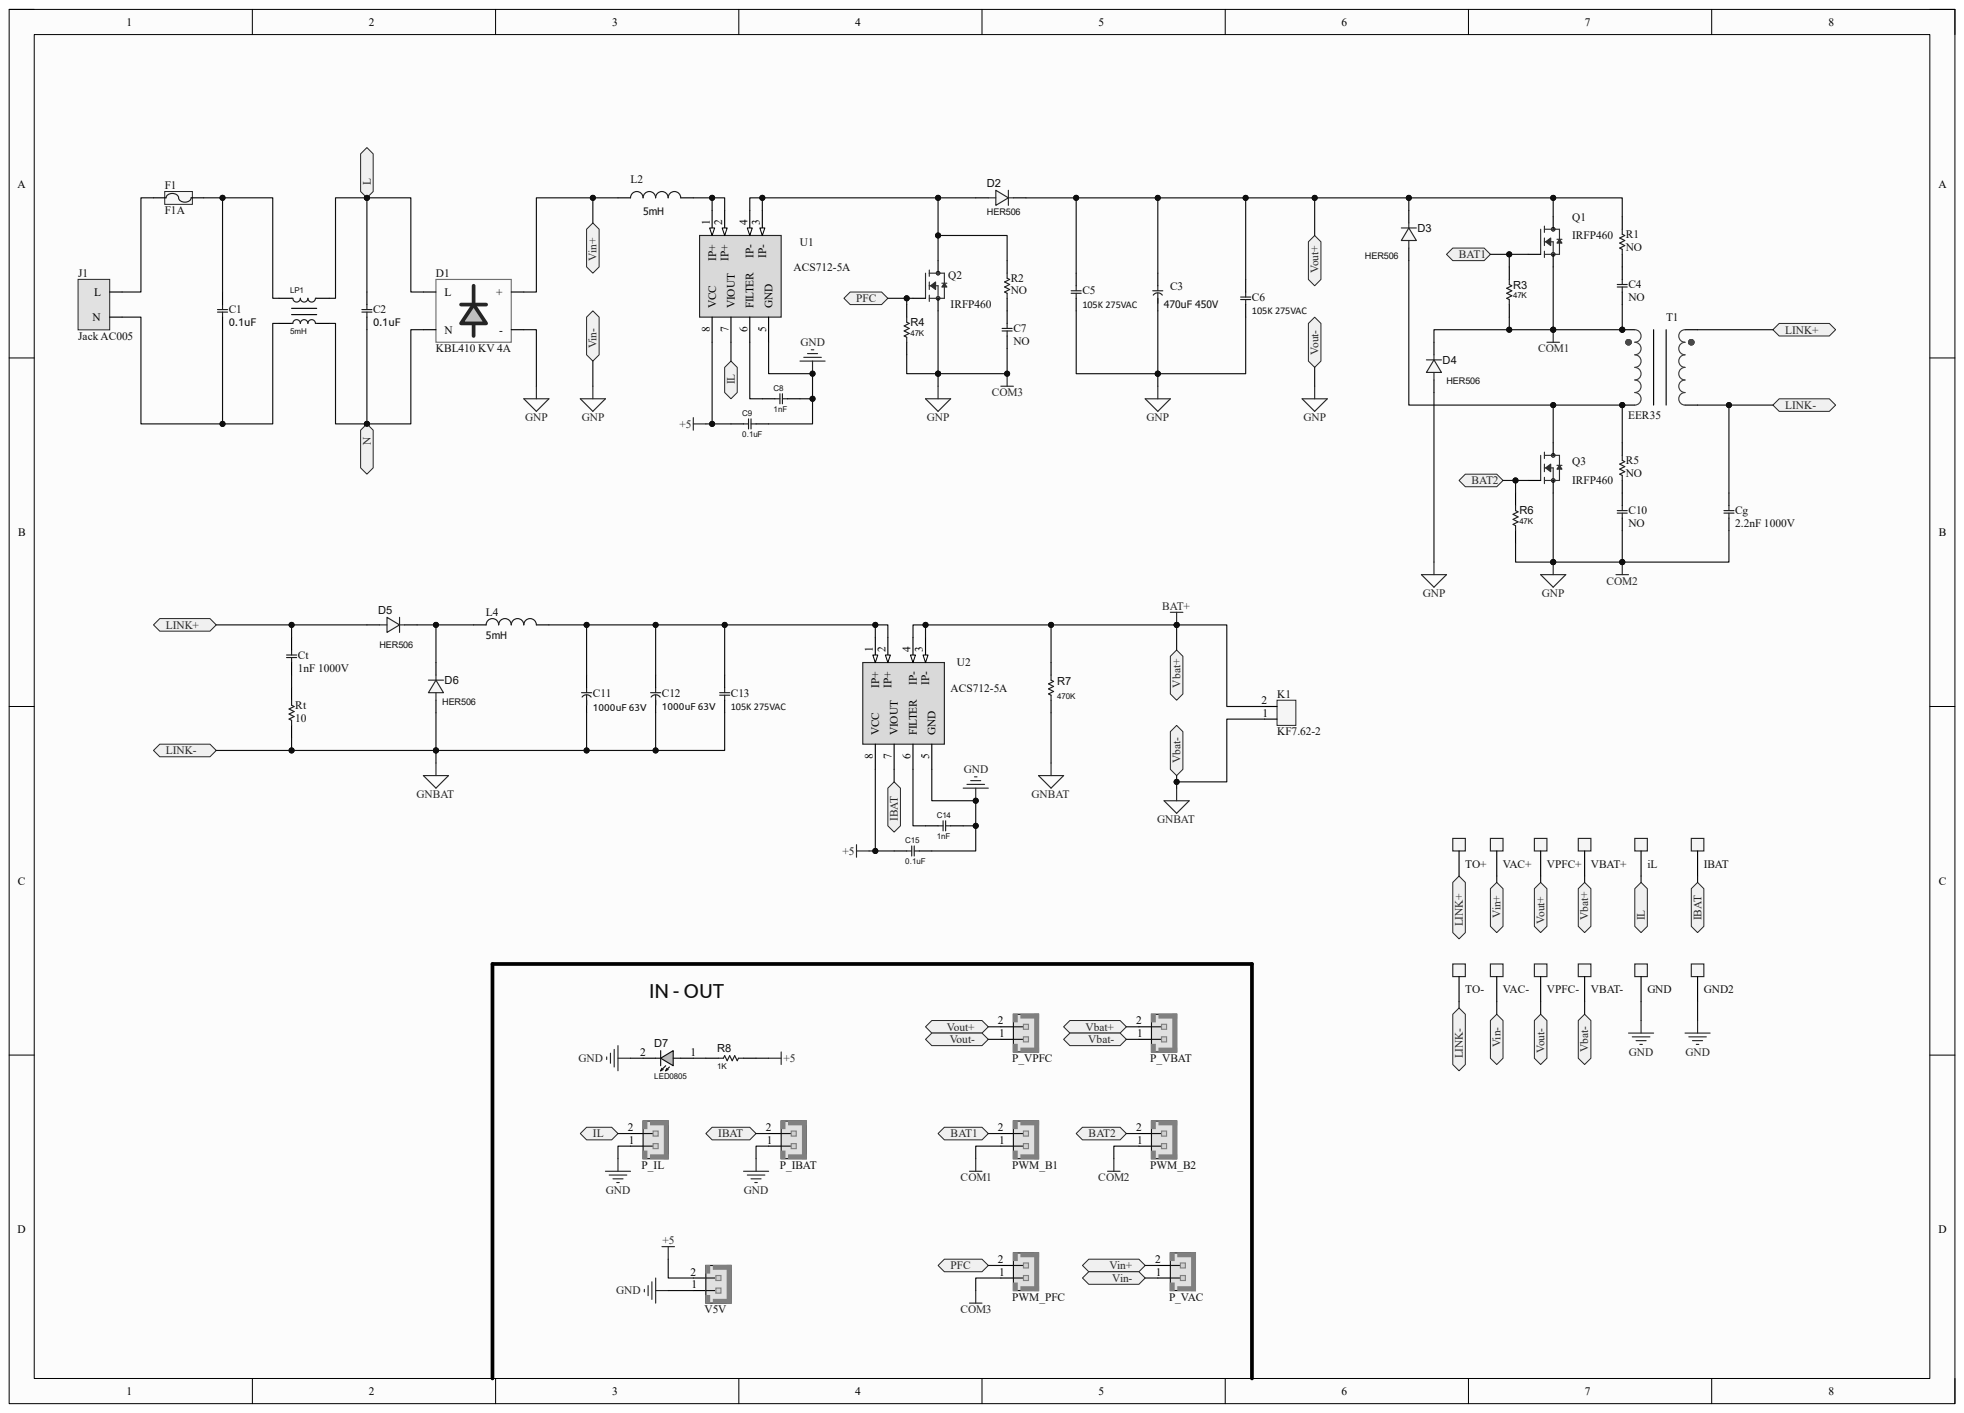
[picture p51: page 1]
