GigaOhms/KLTN/PCB/testSensor/in.pdf

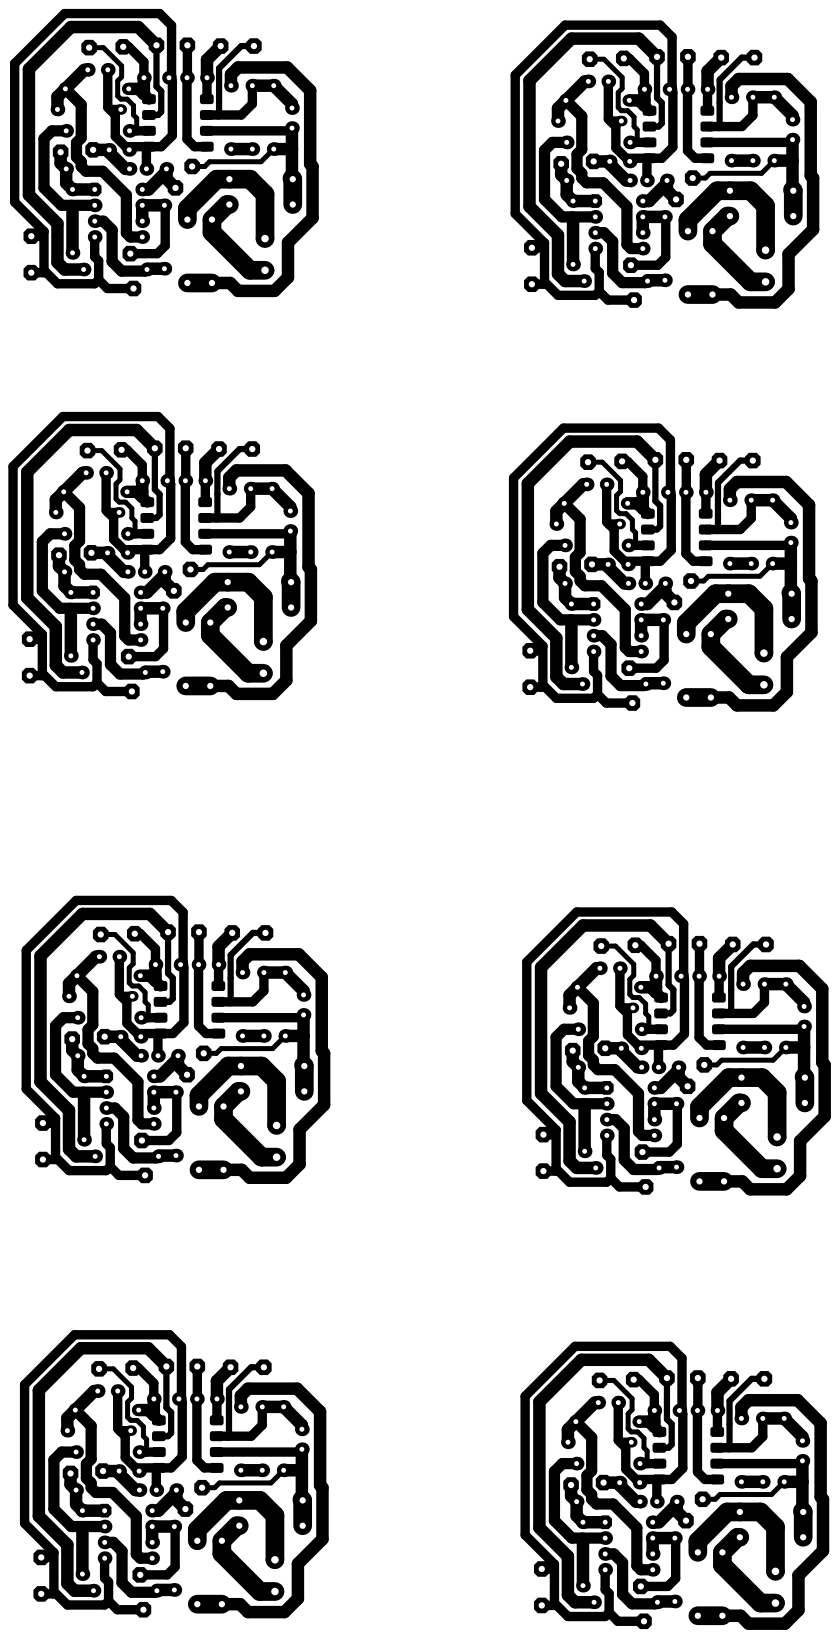
[picture p52: page 1]
