GigaOhms/KLTN/PCB/testTrans/in.pdf

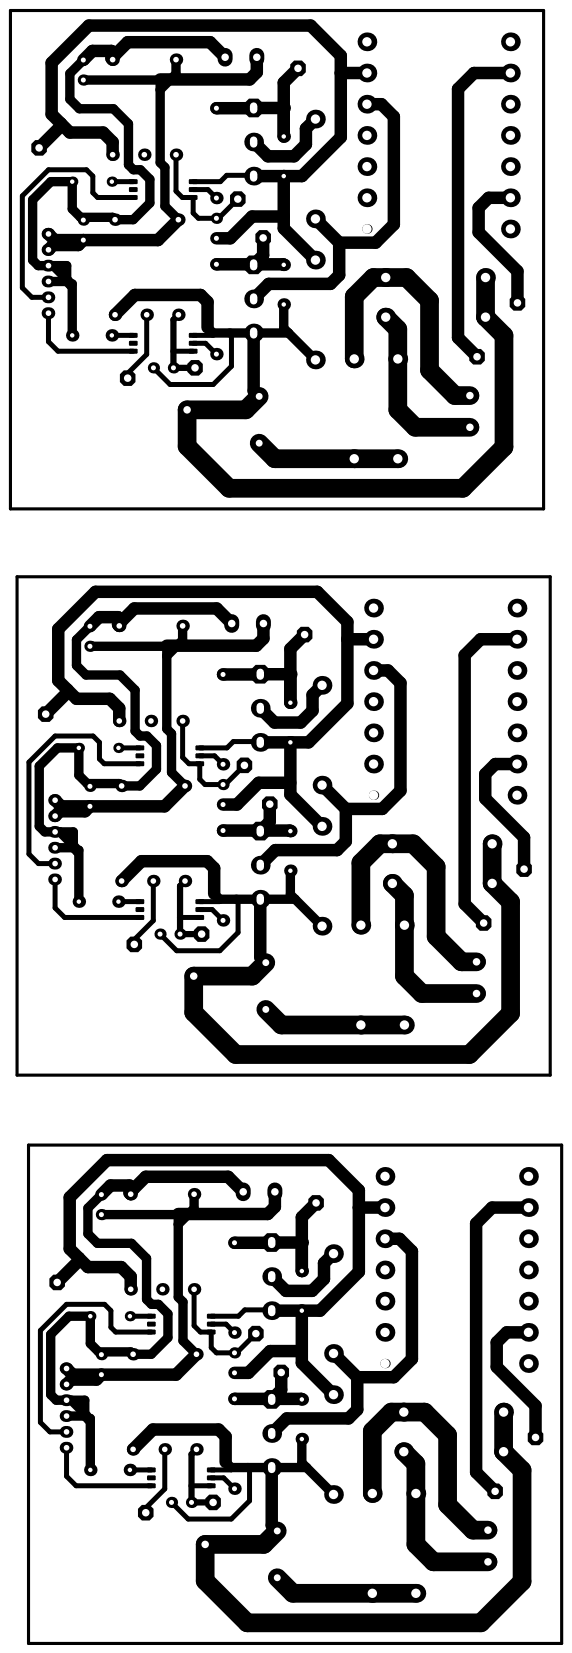
[picture p53: page 1]
