GigaOhms/KLTN/(list of files, drawings)

Other design files:
PCB/ControlBoard/ControlBoard.PrjPcb
PCB/ControlBoard/ControlBoard.SchDoc
PCB/DriverBoard/DriverBoard.PcbDoc
PCB/DriverBoard/DriverBoard.PrjPcb
PCB/DriverBoard/DriverBoard.SchDoc
PCB/PowerBoard/PowerBoard.PrjPcb
PCB/PowerBoard/PowerBoard.SchDoc
PCB/testSensor/testSensor.PcbDoc
PCB/testSensor/testSensor.PrjPcb
PCB/testSensor/testSensor.SchDoc
PCB/testTrans/testTrans.PcbDoc
PCB/testTrans/testTrans.PcbLib
PCB/testTrans/testTrans.PrjPcb
PCB/testTrans/testTrans.SchDoc
PCB/testTrans/testTrans.SCHLIB
Simulation/VoltageSense_42V.ms14
Simulation/VoltageSense_230VAC - Copy.ms14
Simulation/VoltageSense_230VAC.ms14
Simulation/VoltageSense_390VDC.ms14
